ChiranjitPatel/ttsky26d_analog_ADC/docs/specs/layout_briefs/ota.md

# Layout brief — chunk 1b: `ota` (bandgap error amplifier)

**Status: draft 2026-11-08 (night), sizes from the bandgap Phase 2 Monte Carlo.** Final once the bandgap
corner sweep is in (`sim/bandgap/corners.md`).
Schematic: `xschem/ota.sch` (generated by `xschem/gen_ota.py`). Netlist: `sim/out/netlist/ota.spice`.
Why these sizes: `sim/bandgap/README.md` ("Phase 2 — mismatch"). The OTA offset is multiplied by about 10 onto VBG,
so the input pair and the loads are large on purpose. **Matching is the main job of this layout.**

## What it does

This is a two-stage Miller OTA with a PMOS-lvt input. Inputs `inp` = `vb` and `inn` = `va` come from the bandgap
core (about 0.6–0.7 V), and the output `out` = `vgp` drives the gates of the bandgap PMOS current sources. It is
biased from `bias_gen` (`pbias`, 1 µA per pfet_lvt 2/2 unit). Power-down is `pd` = 1.

## Devices

| Name | Device | W / L (µm) | Count | D / G / S / B | Notes |
|---|---|---|---|---|---|
| M1 | pfet_01v8_lvt | 32 / 8 | 1 | d1 / inn / tail / VDPWR | **input pair**, matched with M2 |
| M2 | pfet_01v8_lvt | 32 / 8 | 1 | out1 / inp / tail / VDPWR | |
| M5 | pfet_01v8_lvt | 2 / 2 | 2 (mult) | tail / pbias / VDPWR / VDPWR | tail, 2 µA |
| M3 | nfet_01v8 | 4 / 16 | 1 | d1 / d1 / VGND / VGND | **mirror load**, matched with M4 |
| M4 | nfet_01v8 | 4 / 16 | 1 | out1 / d1 / VGND / VGND | |
| M6 | nfet_01v8 | 4 / 16 | 4 (mult) | out / out1 / VGND / VGND | 2nd stage, 4× the M4 current density |
| M7 | pfet_01v8_lvt | 2 / 2 | 4 (mult) | out / pbias / VDPWR / VDPWR | 2nd-stage load, 4 µA |
| RZ | res_xhigh_po_0p35 | 0.35 / 21 | 1 | out1 – cz | ≈ 120 kΩ; may be split into series units (tell me) |
| CC | cap_mim_m3_1 | 32 × 32 | 1 | cz (bottom, met3) – out (top, met4) | ≈ 2.1 pF |
| MPD | pfet_01v8 | 0.42 / 0.5 | 1 | out / pdb / VDPWR / VDPWR | power-down |
| MND | nfet_01v8 | 0.42 / 0.5 | 1 | out1 / pd / VGND / VGND | power-down |
| MIP, MIN | pfet / nfet_01v8 | 0.84 / 1, 0.42 / 1 | 1 each | pd inverter → pdb | |
| dummies | as below | | | all terminals on the rail | added to the schematic before you draw |

## Matching (CLAUDE.md rule 6)

1. **Input pair M1/M2:** split each into **2 × 16/8** (LVS merges parallel devices) and interdigitate as
   **`D  A B B A  D`** (common centroid, A = M1, B = M2). Dummies are pfet_01v8_lvt 16/8 on VDPWR. Use one
   n-well and the same orientation, with an n-tap guard ring around the pair. Keep `tail` short and
   symmetric to both halves.
2. **Loads M3/M4 + M6:** one row of 4/16 units: **`D  M6 M6 M3 M4 M6 M6  D`**. M3 and M4 sit in the middle,
   next to each other, and the M6 units are symmetric around them. Dummies are nfet 4/16 on VGND. Put a p-tap
   guard ring around the row.
3. **Tail M5 and load M7** are 2/2 units from `pbias`, like the bias_gen unit devices. Their matching isn't
   critical.
4. **CC over the devices:** the 32 × 32 µm MIM (met3 bottom plate `cz`, met4 top plate `out`) can sit over the
   input pair or the load row. Then no met3 routing is allowed there. Put `out` (top plate, met4) on the
   low-impedance side. That's already the schematic's orientation (c1 = out).
5. Keep `inp`/`inn` (to the bandgap's `vb`/`va`) symmetric, short, and away from `out`/`vgp`.

## Outline and pins

This sits inside `bandgap_core` (54 × 94 µm in the floorplan), next to `pnp_array` and `bg_res`
(`layout_briefs/scripted_cells.md`). A target outline of about 40 × 40 µm with CC on top works. Pins:
`inp`, `inn`, `out`, `pbias`, `pd`, VDPWR, VGND on met1/met2, with labels named exactly like that.

## Checks

```bash
python3 layout/check_cell.py ota --gds <your file>.gds
```

```bash
python3 layout/klayout_drc.py <your file>.gds
```

The first runs Magic DRC and LVS against the schematic (dummies included), the second the TT KLayout deck.
