ChiranjitPatel/ttsky26d_analog_ADC/sim/bandgap/corners.md

# bandgap_core — Phase 2 corners (generated by corners_report.py)

63 runs: corners tt/ff/ss/fs/sf/ll/hh (ll/hh = low/high resistor corner) × −40/27/125 °C × VDPWR 1.62/1.80/1.98 V. Failed runs: 0.

## VBG at 27 °C, 1.80 V

| corner | VBG (V) | vs tt | TC −40…125 °C (ppm/°C) | line (mV/V) |
|---|---|---|---|---|
| tt | 1.2105 | +0.00 % | 23.5 | 2.22 |
| ff | 1.2059 | -0.38 % | 33.3 | 1.98 |
| ss | 1.2146 | +0.34 % | 20.3 | 2.72 |
| fs | 1.2103 | -0.02 % | 26.8 | 2.03 |
| sf | 1.2107 | +0.02 % | 22.4 | 2.89 |
| ll | 1.2117 | +0.10 % | 20.7 | 2.32 |
| hh | 1.2093 | -0.10 % | 26.3 | 2.13 |

## Summary over all runs

| Spec | Quantity | Result | Target | |
|---|---|---|---|---|
| B6 | VBG spread, all corners at 27 °C / 1.8 V | 1.2059 … 1.2146 V (-0.4 / +0.3 %) | ±3 % (untrimmed) | ✅ |
| — | VBG, every corner × T × VDD | 1.1983 … 1.2151 V | — | |
| B5 | TC, worst corner (1.8 V) | 33.3 ppm/°C | ≤ 50 ppm/°C | ✅ |
| B4 | Line regulation, worst run | 9.88 mV/V | ≤ 10 mV/V | ✅ |
| B3 | Startup (1 µs and 100 µs ramps, settles, no oscillation) | 63/63 runs | all | ✅ |

Mismatch (Monte Carlo, `tb_bandgap_mc.spice`, 100 seeds, tt): see `README.md`.
