ChiranjitPatel/ttsky26d_analog_ADC/material/schematics/stage1_bias_gen.png

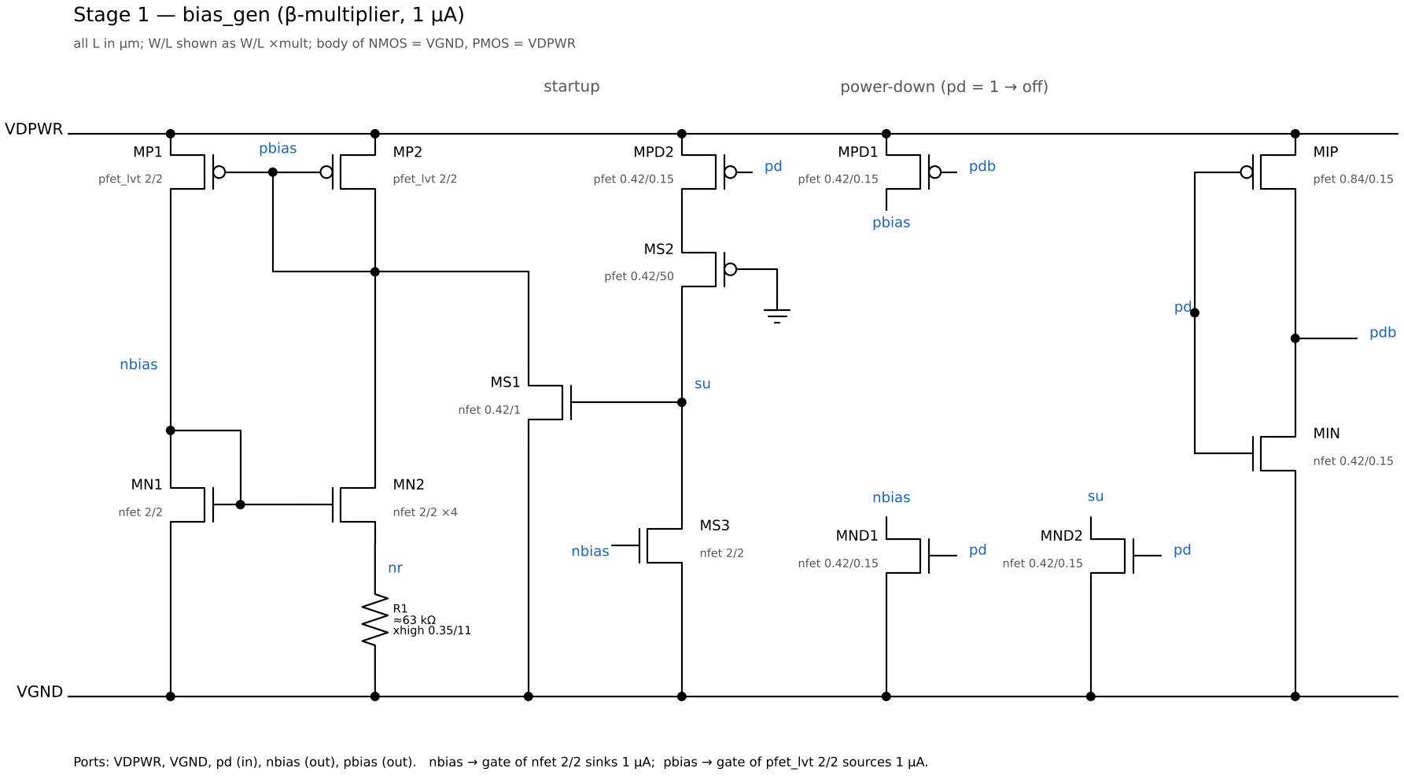
material/schematics/stage1_bias_gen.png
