ChiranjitPatel/ttsky26d_analog_ADC/material/schematics/stage2_ota.png

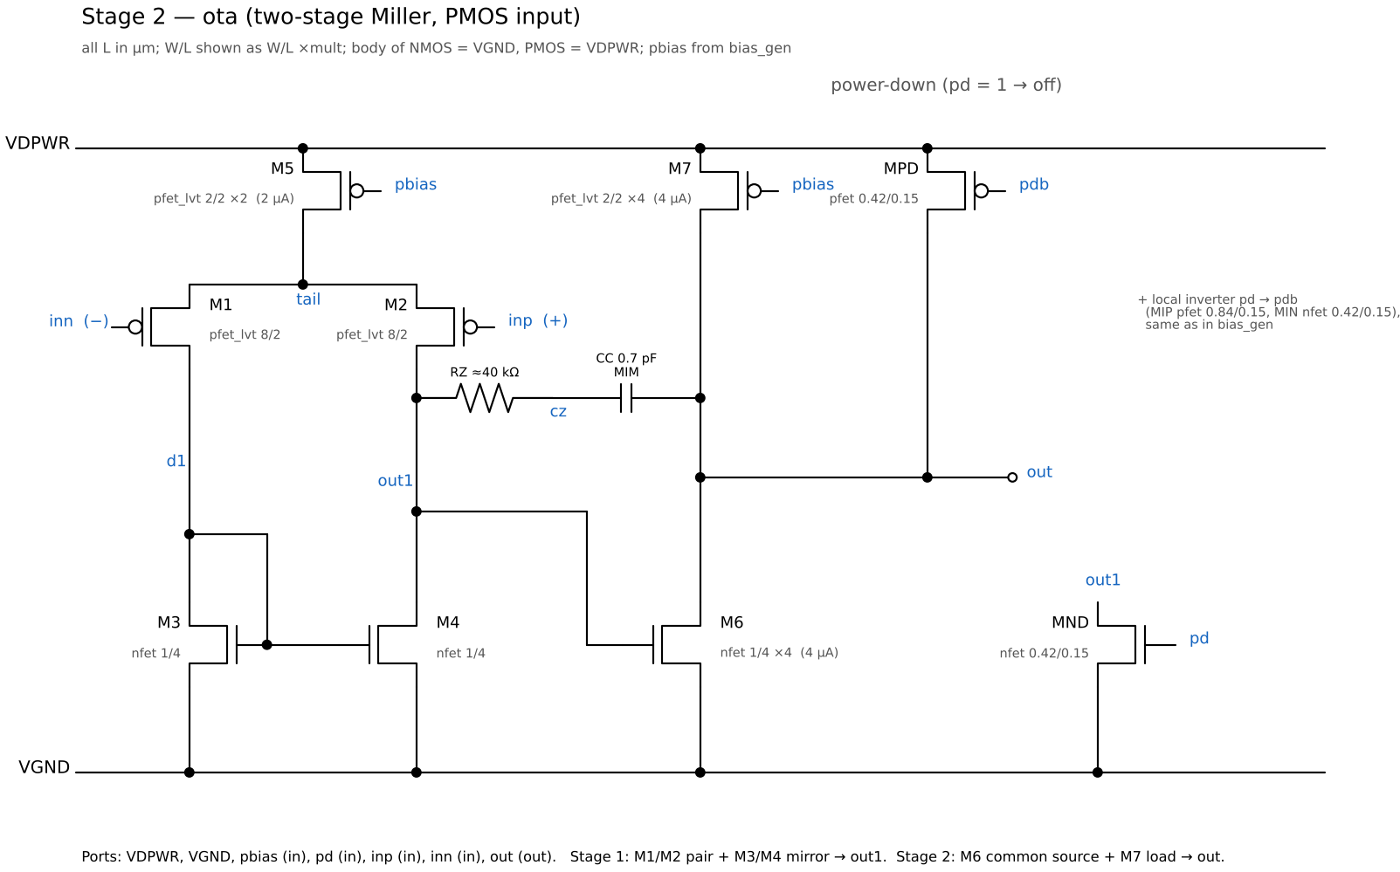
material/schematics/stage2_ota.png
