ChiranjitPatel/ttsky26d_analog_ADC/material/schematics/stage3_bandgap_core.png

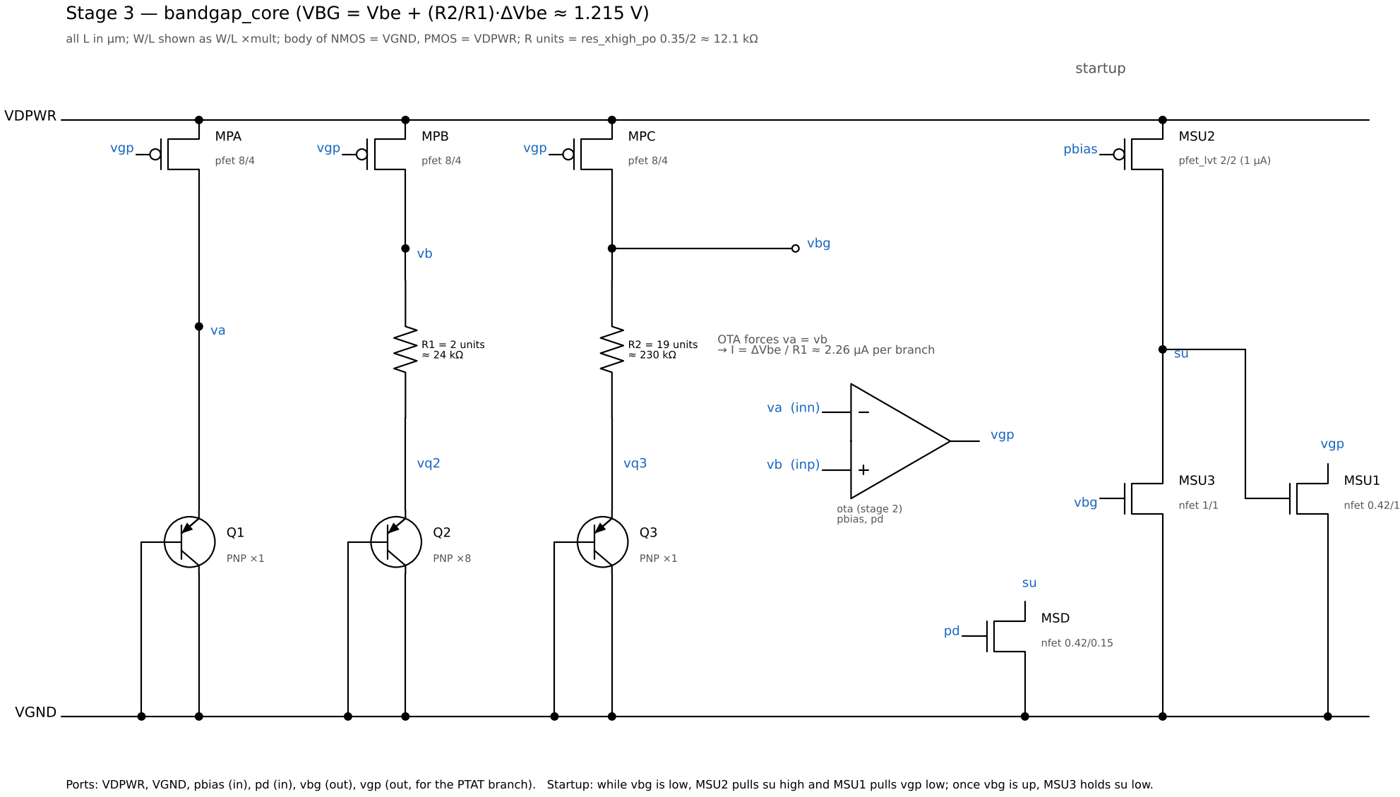
material/schematics/stage3_bandgap_core.png
