ChiranjitPatel/ttsky26d_analog_ADC/material/schematics/stage4_ptat_out.png

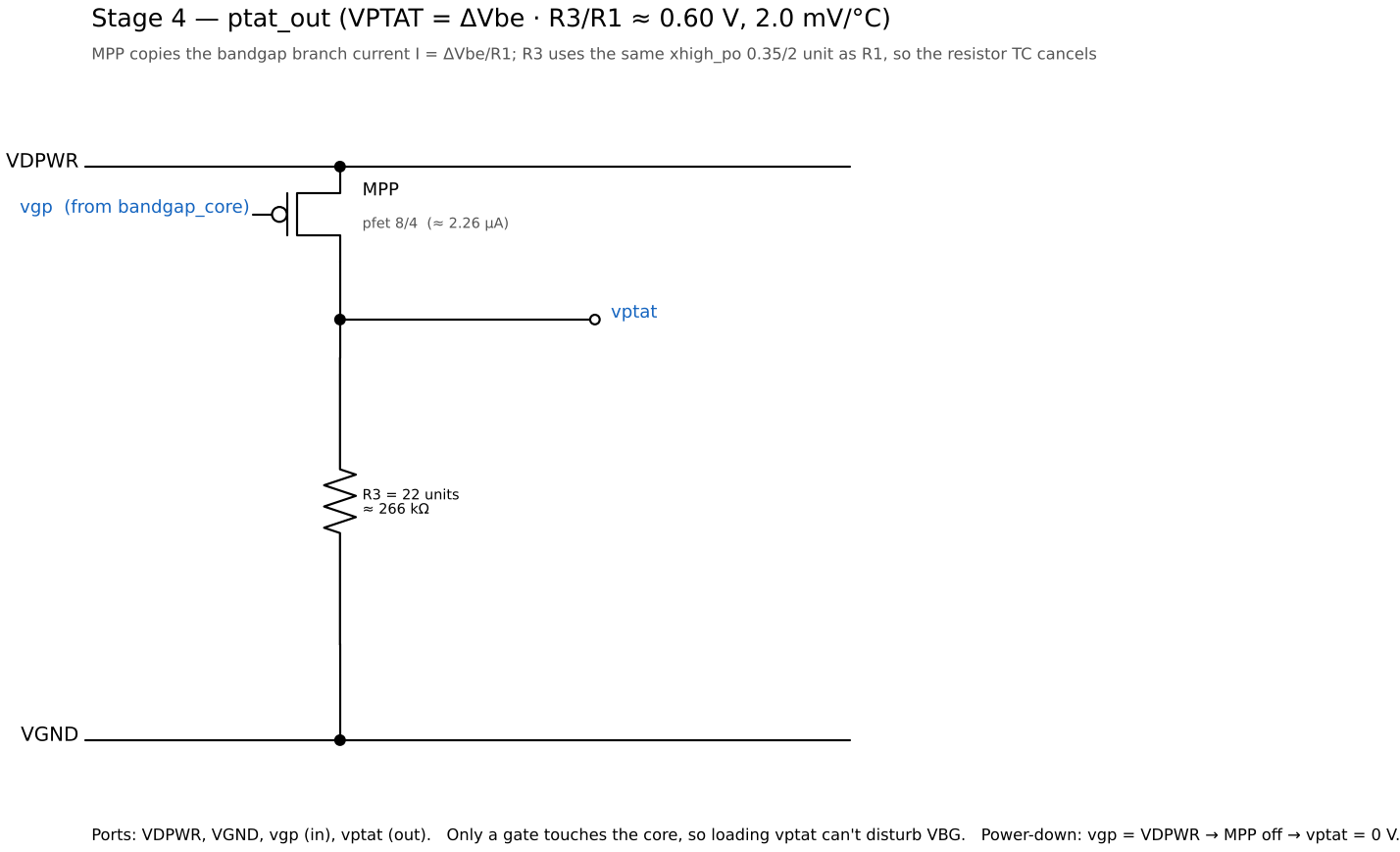
material/schematics/stage4_ptat_out.png
