ChiranjitPatel/ttsky26d_analog_ADC/material/schematics/stage5_vref.png

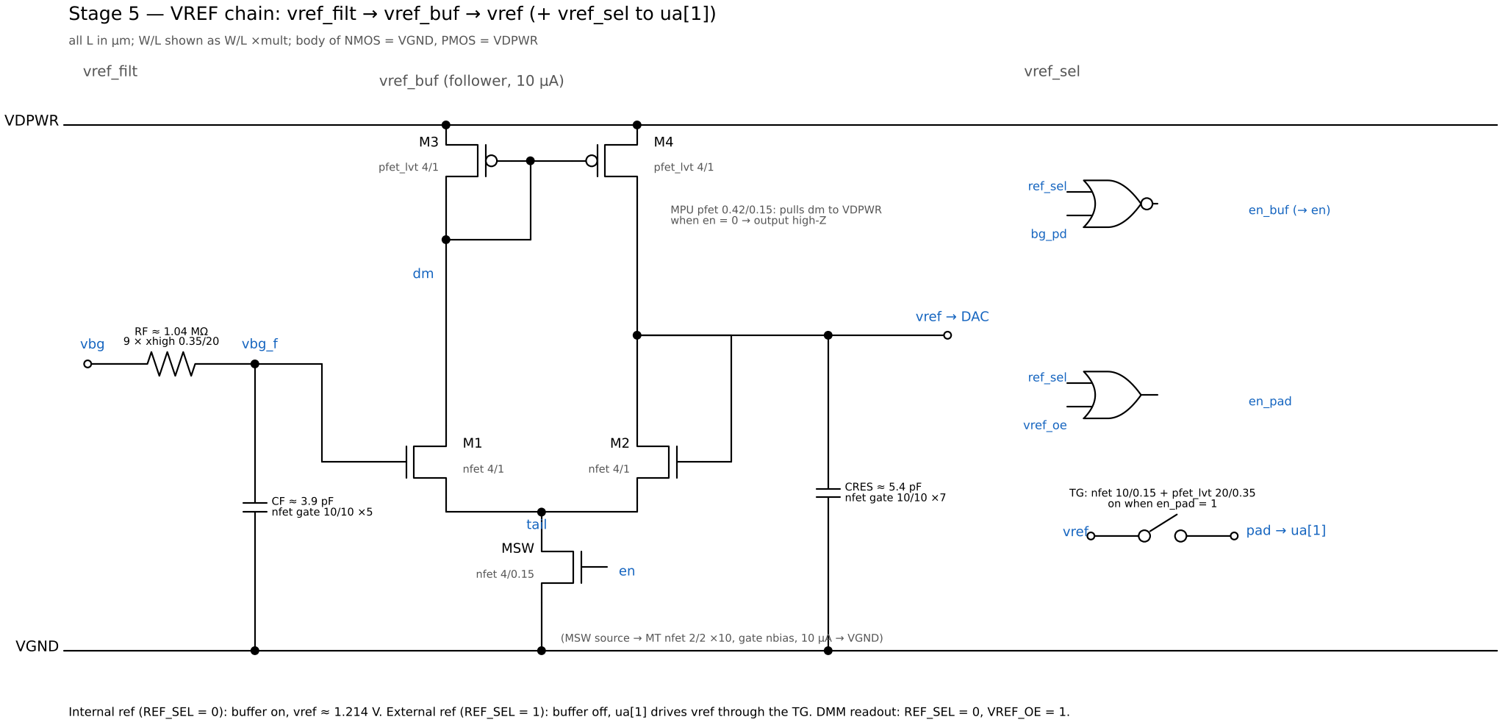
material/schematics/stage5_vref.png
