ChiranjitPatel/ttsky26d_analog_ADC/material/schematics/stage6_comparator.png

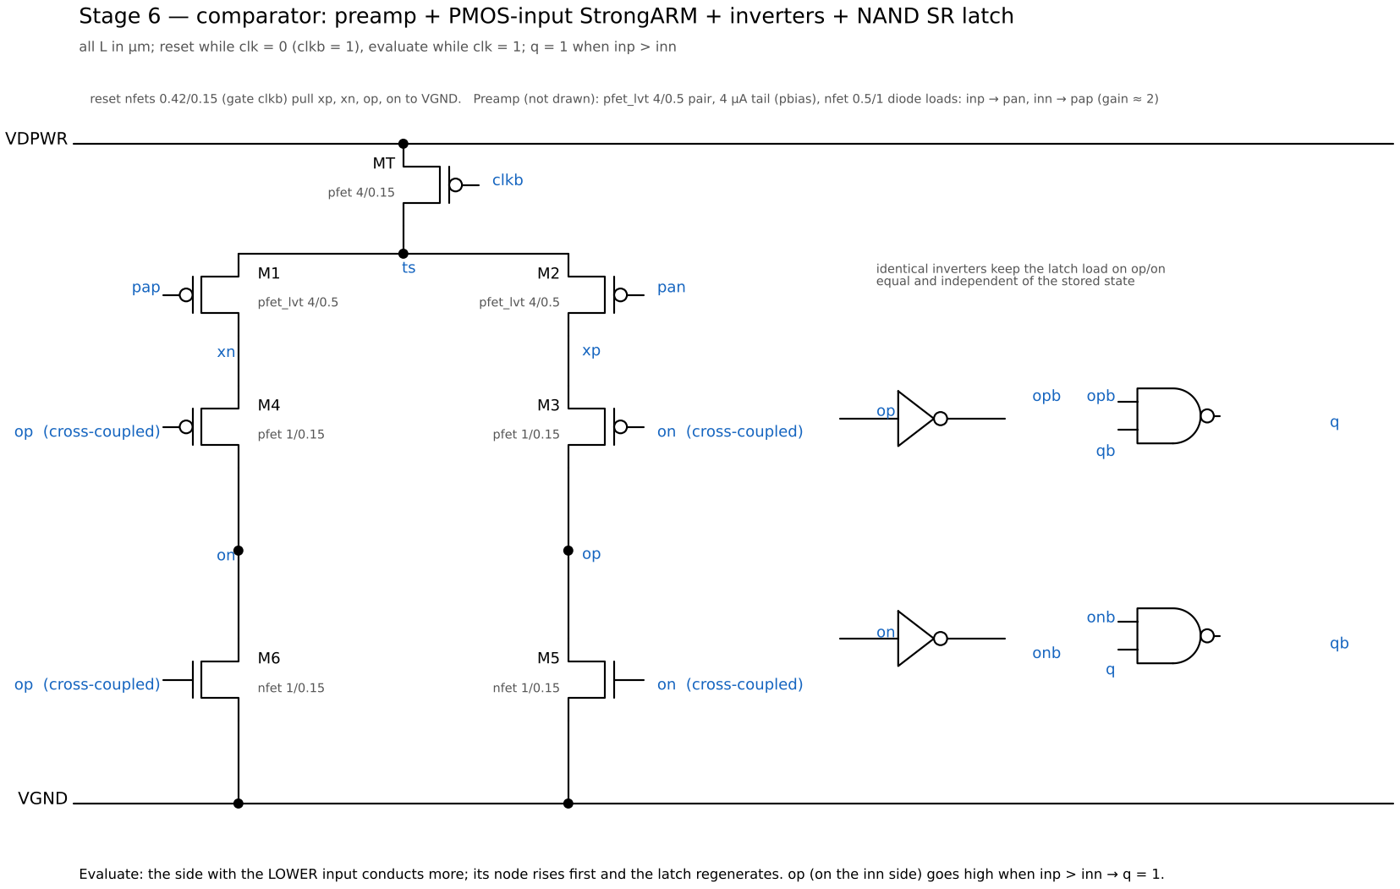
material/schematics/stage6_comparator.png
