ChiranjitPatel/ttsky26d_analog_ADC/material/schematics/stage7_inmux_vcm.png

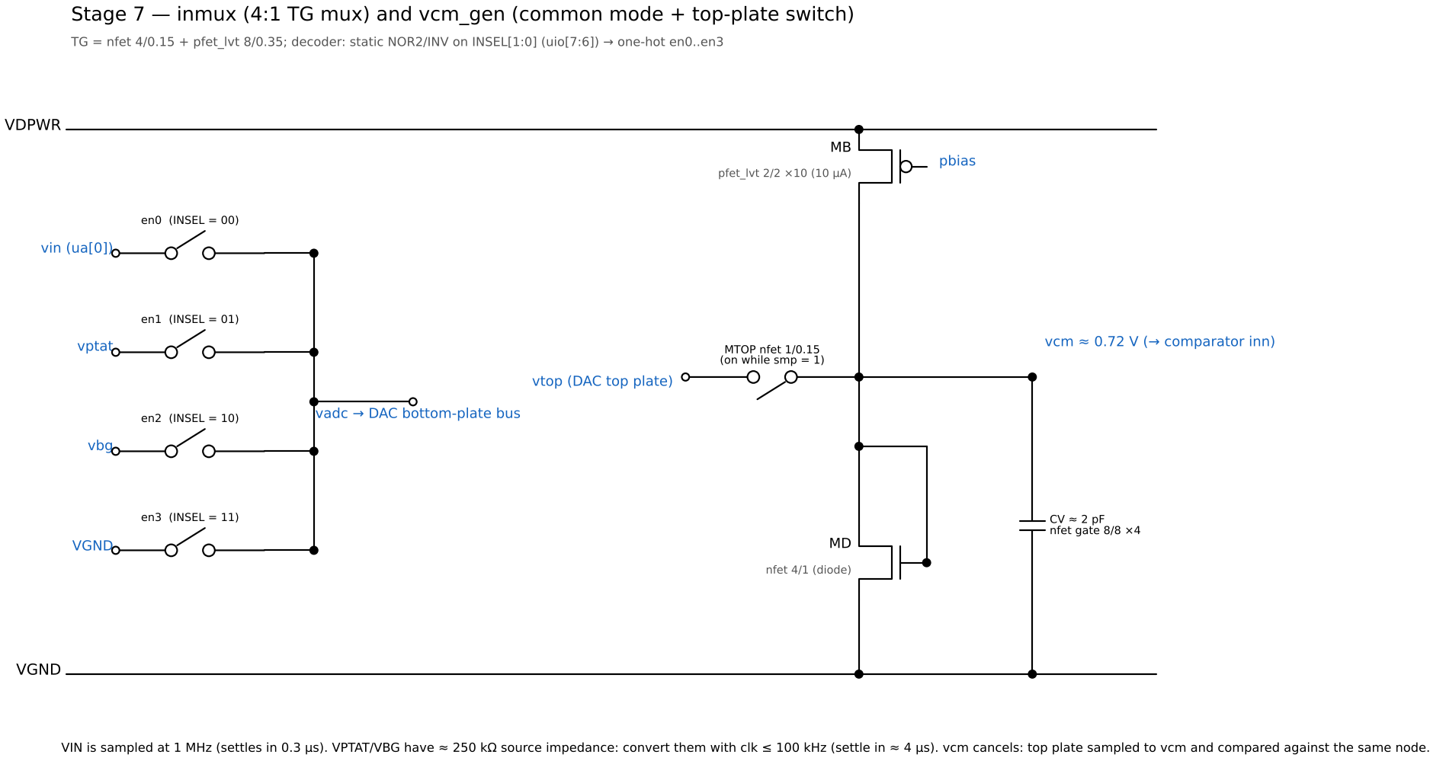
material/schematics/stage7_inmux_vcm.png
