ChiranjitPatel/ttsky26d_analog_ADC/material/schematics/stage8_cap_dac.png

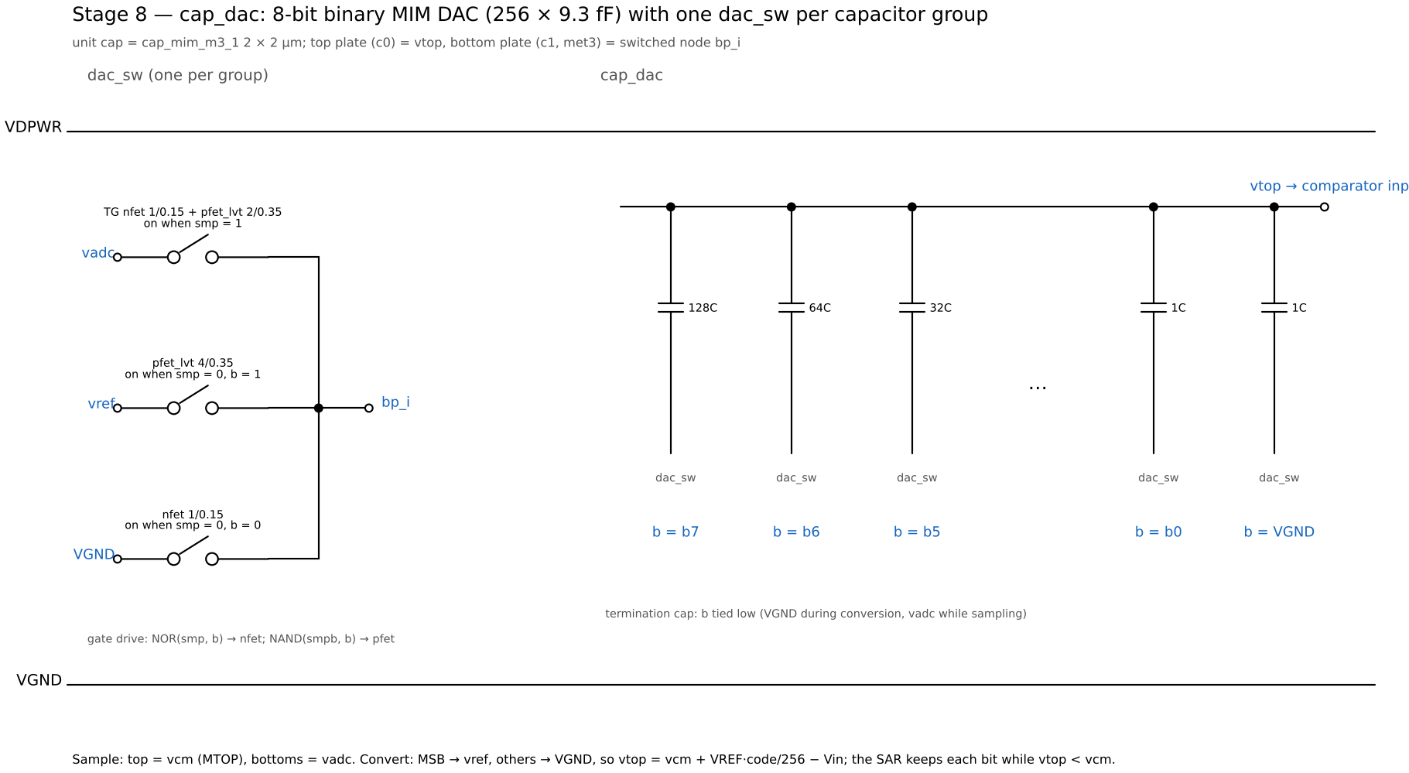
material/schematics/stage8_cap_dac.png
