ChiranjitPatel/ttsky26d_analog_ADC/sim/bandgap/plots/corners.png

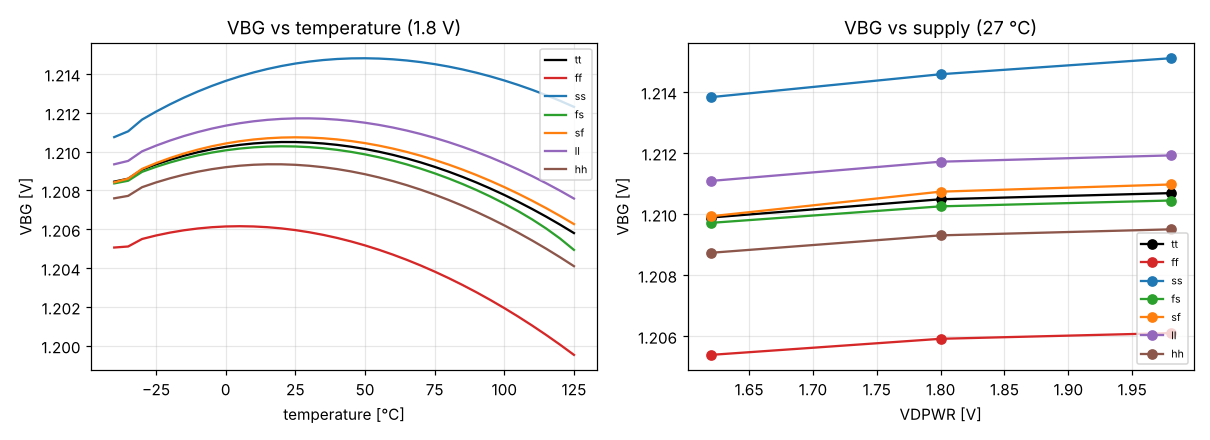
sim/bandgap/plots/corners.png
