ChiranjitPatel/ttsky26d_analog_ADC/sim/bias/plots/corners.png

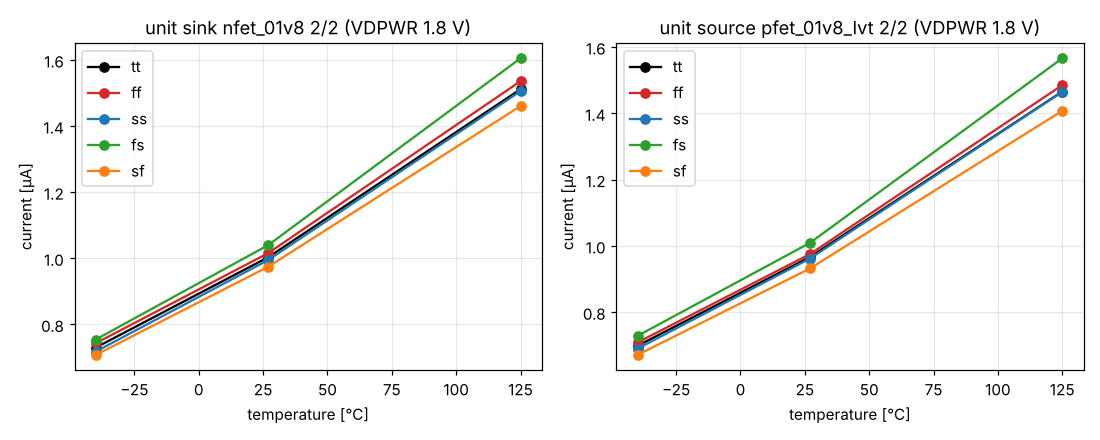
sim/bias/plots/corners.png
