ChiranjitPatel/ttsky26d_analog_ADC/sim/devices/plots/nfet_01v8.png

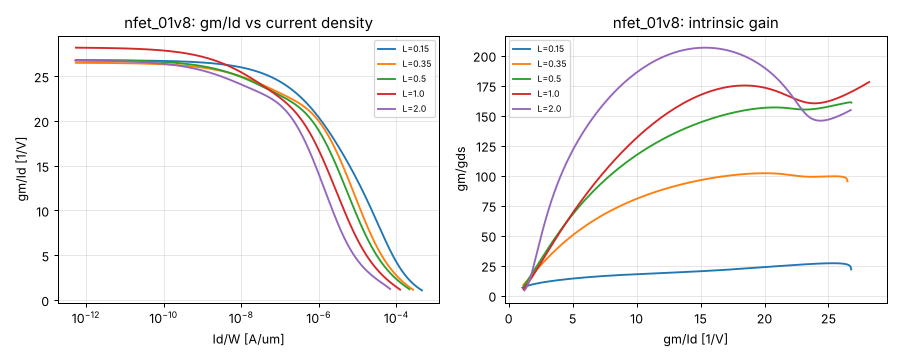
sim/devices/plots/nfet_01v8.png
