ChiranjitPatel/ttsky26d_analog_ADC/sim/devices/plots/pfet_01v8.png

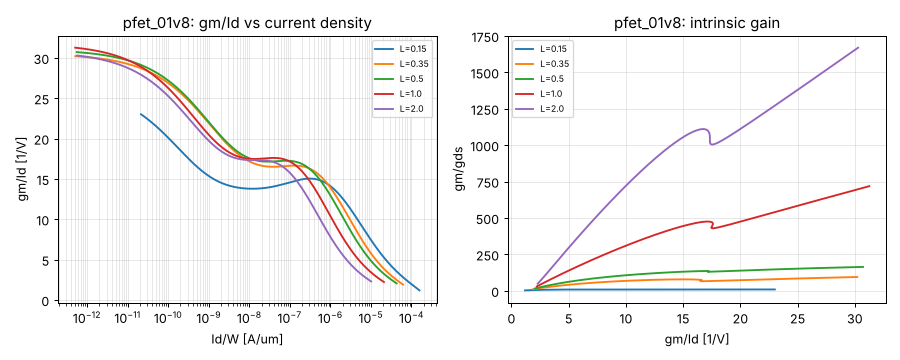
sim/devices/plots/pfet_01v8.png
