ChiranjitPatel/ttsky26d_analog_ADC/sim/devices/plots/pnp.png

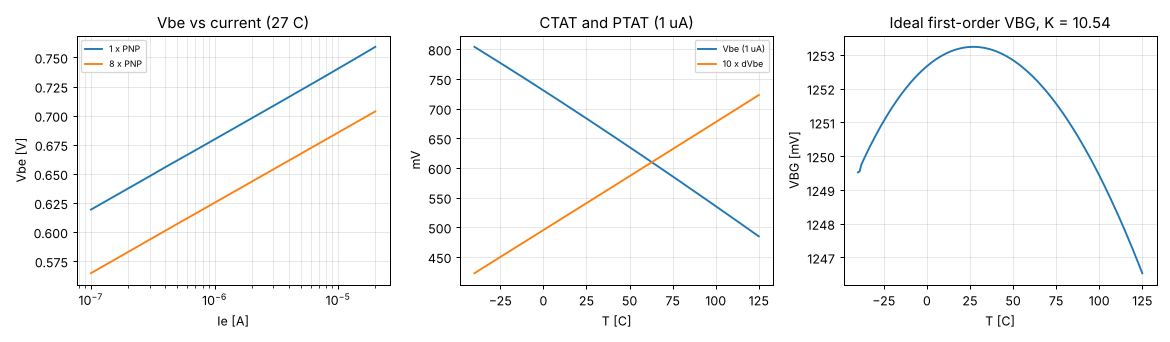
sim/devices/plots/pnp.png
