ChiranjitPatel/ttsky26d_analog_ADC/sim/ptat/plots/sensor.png

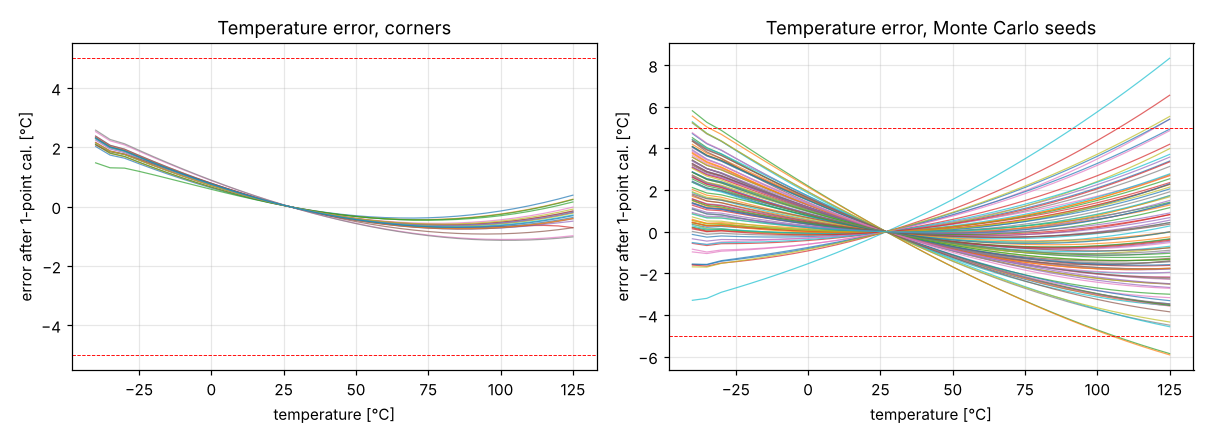
sim/ptat/plots/sensor.png
