ChiranjitPatel/ttsky26d_analog_ADC/material/layout/bandgap_core.png

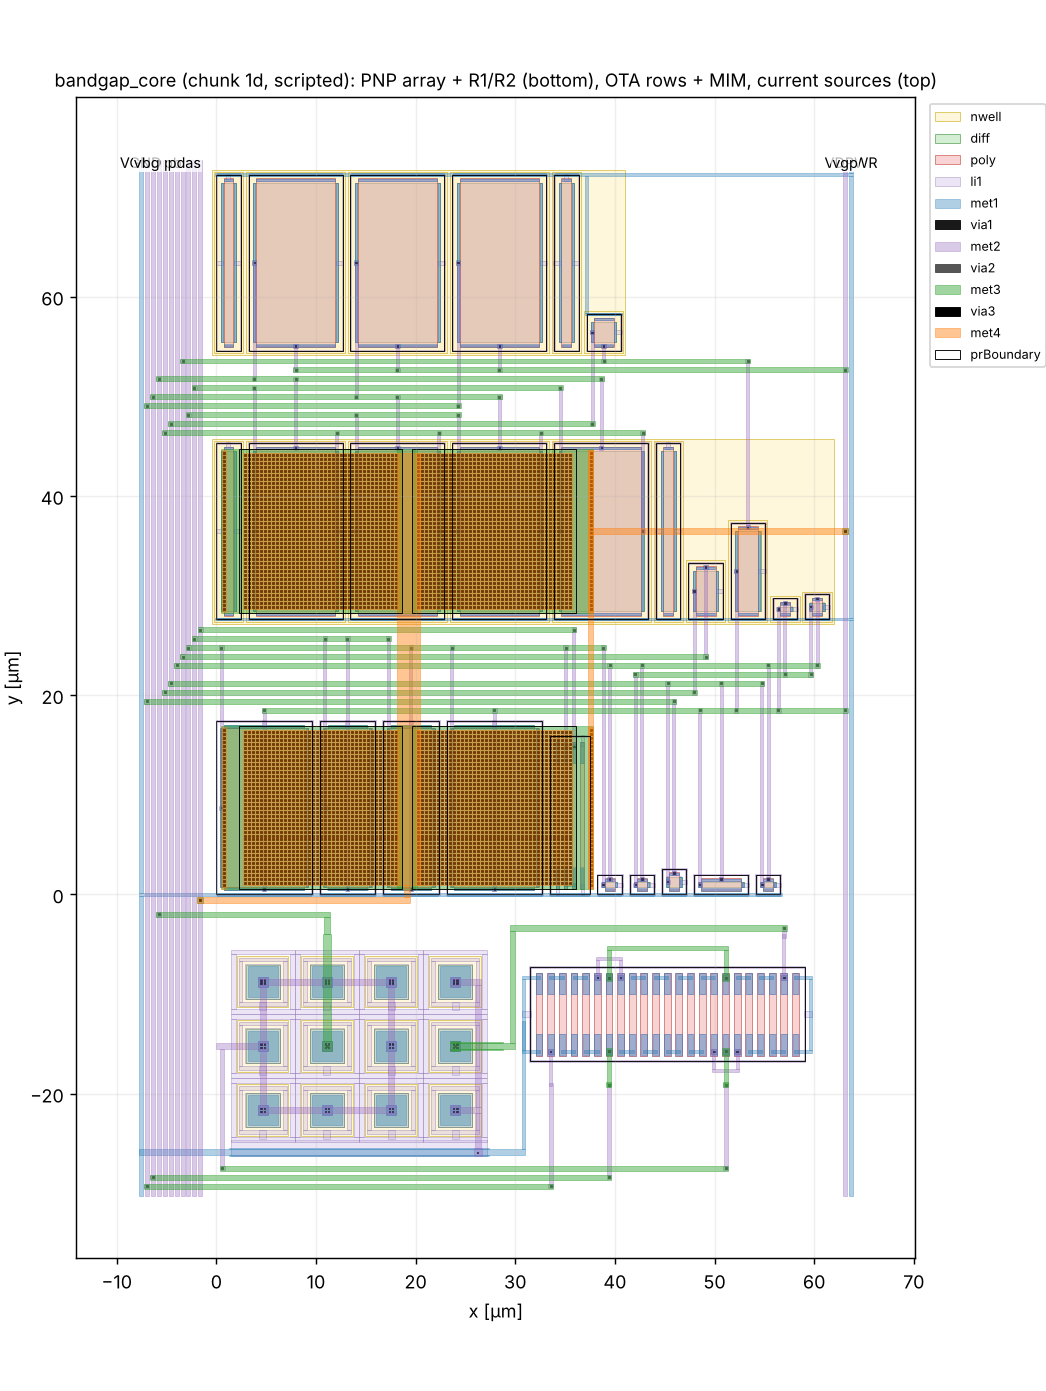
material/layout/bandgap_core.png
