ChiranjitPatel/ttsky26d_analog_ADC/material/layout/bg_res.png

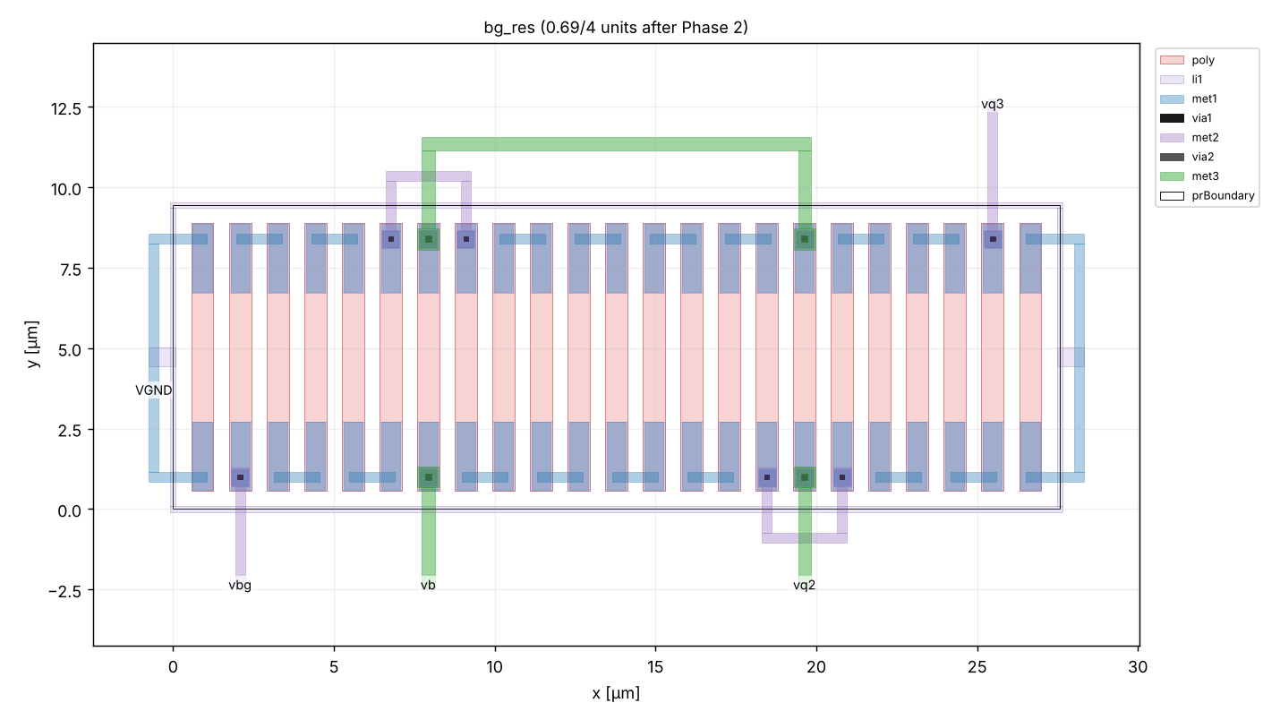
material/layout/bg_res.png
