ChiranjitPatel/ttsky26d_analog_ADC/material/layout/bias_gen.png

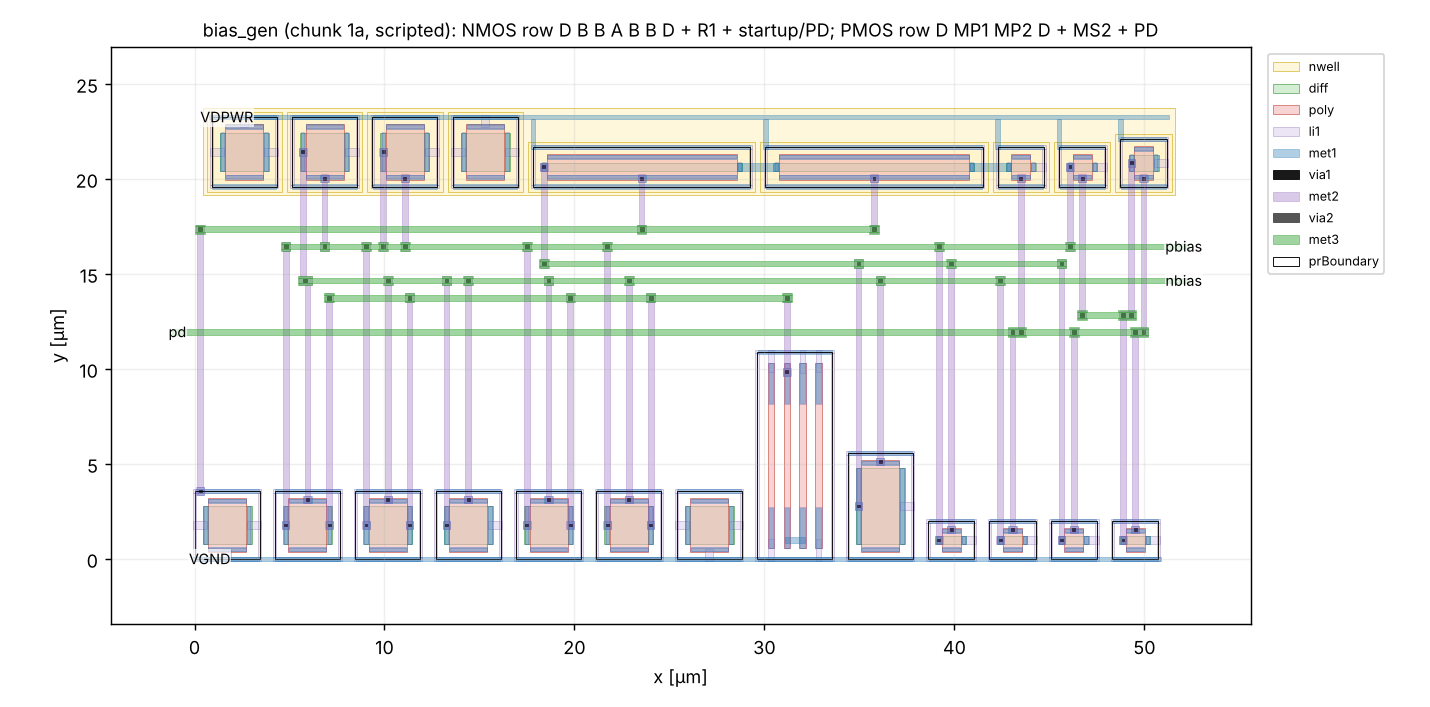
material/layout/bias_gen.png
