ChiranjitPatel/ttsky26d_analog_ADC/material/layout/floorplan.png

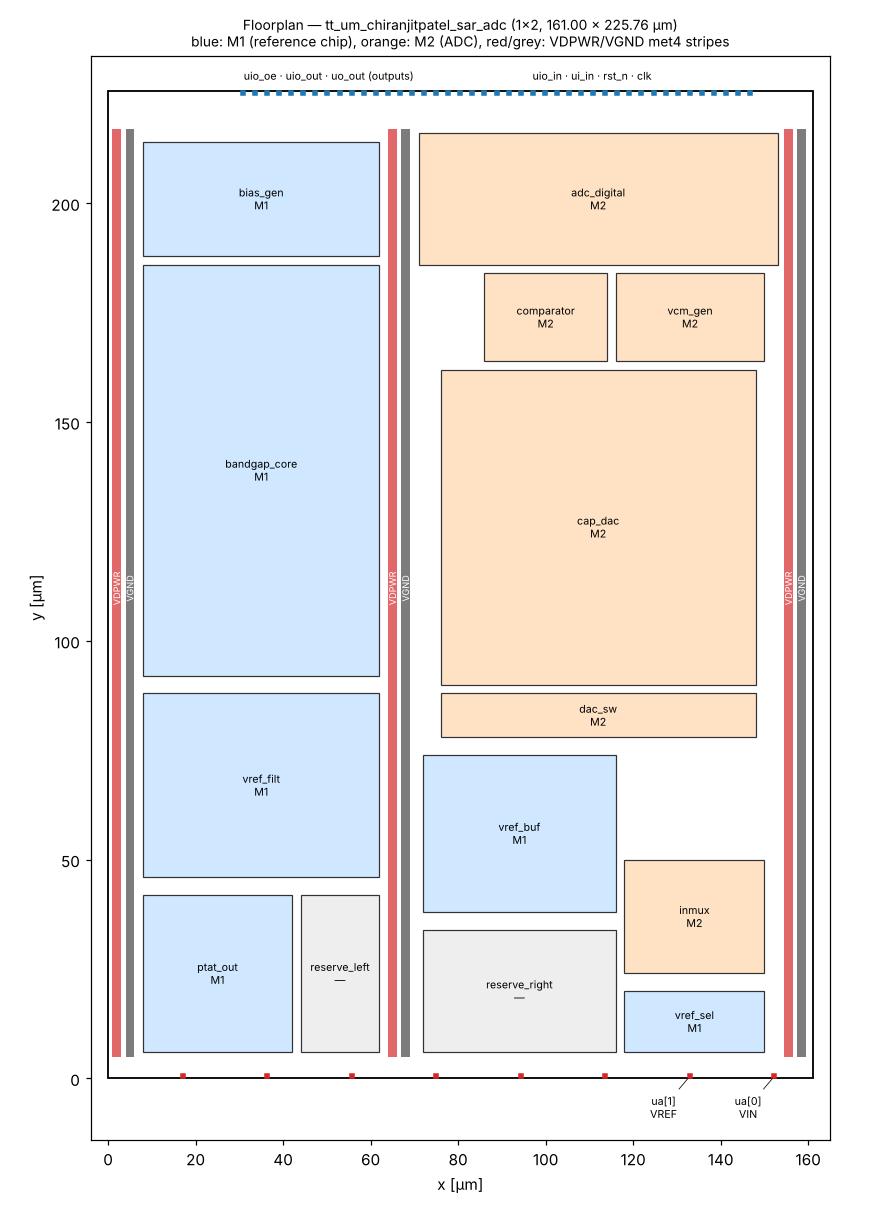
material/layout/floorplan.png
