ChiranjitPatel/ttsky26d_analog_ADC/material/layout/m0_frame.png

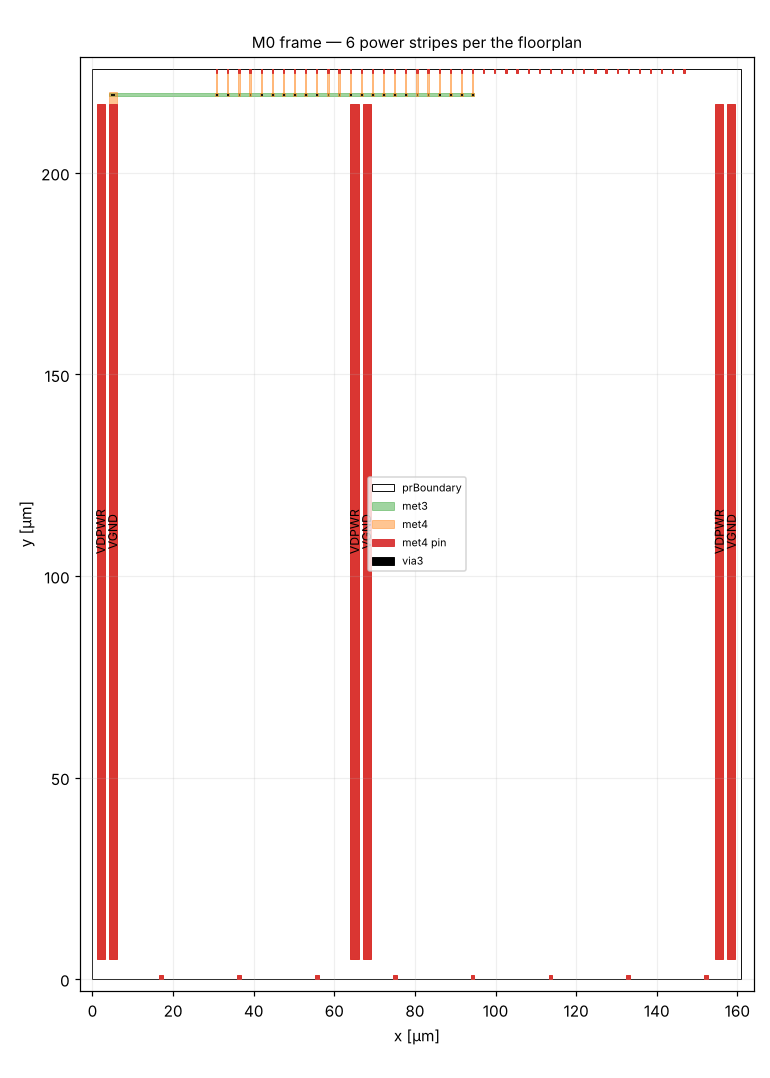
material/layout/m0_frame.png
