ChiranjitPatel/ttsky26d_analog_ADC/material/layout/ota.png

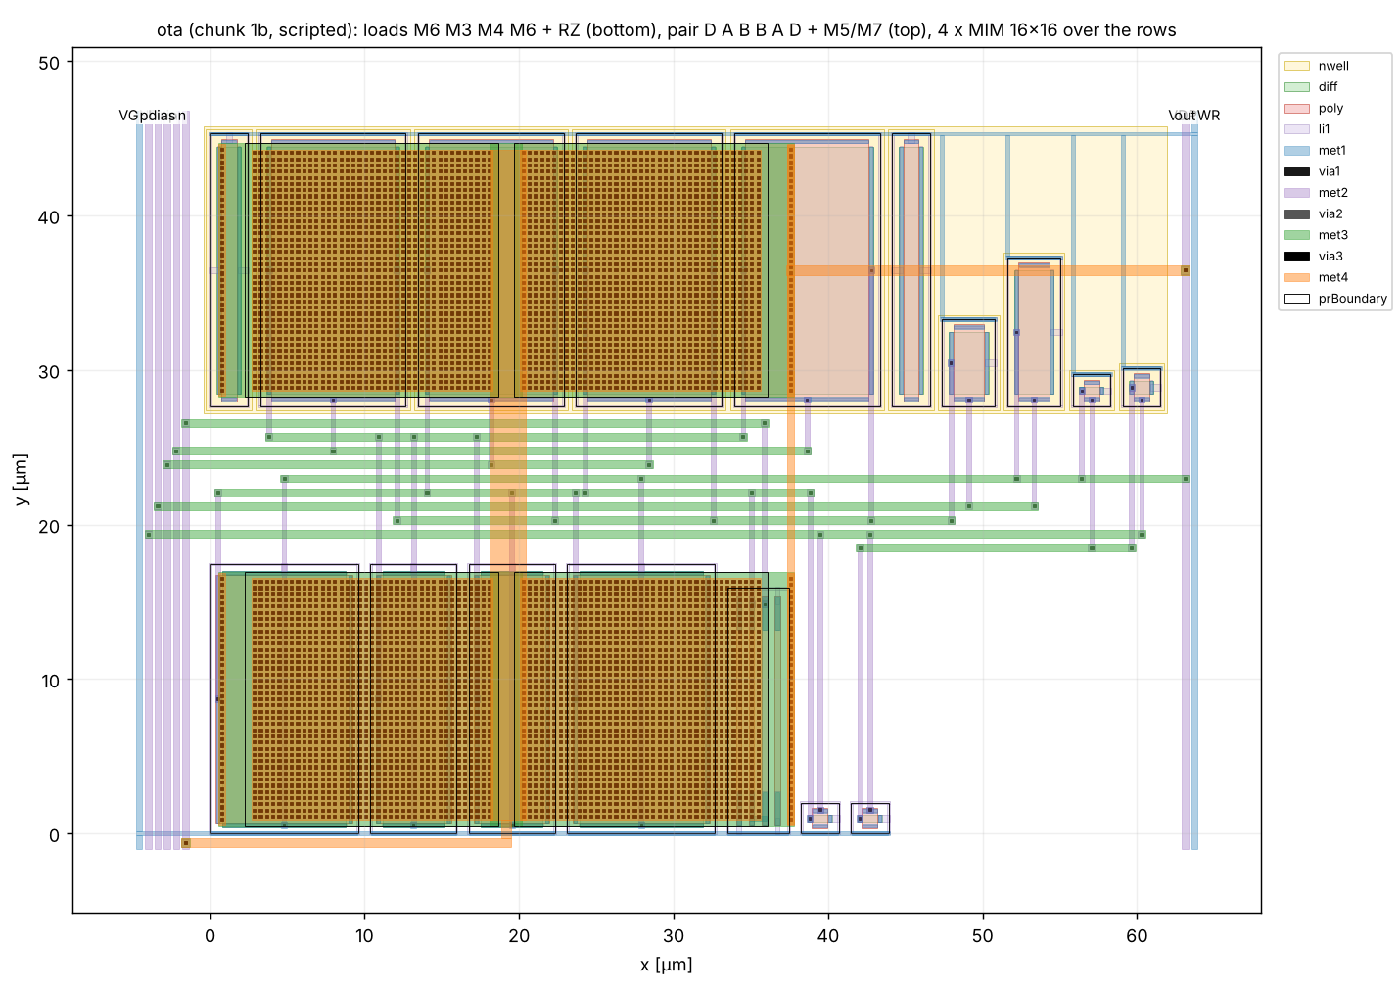
material/layout/ota.png
