ChiranjitPatel/ttsky26d_analog_ADC/material/layout/pnp_array.png

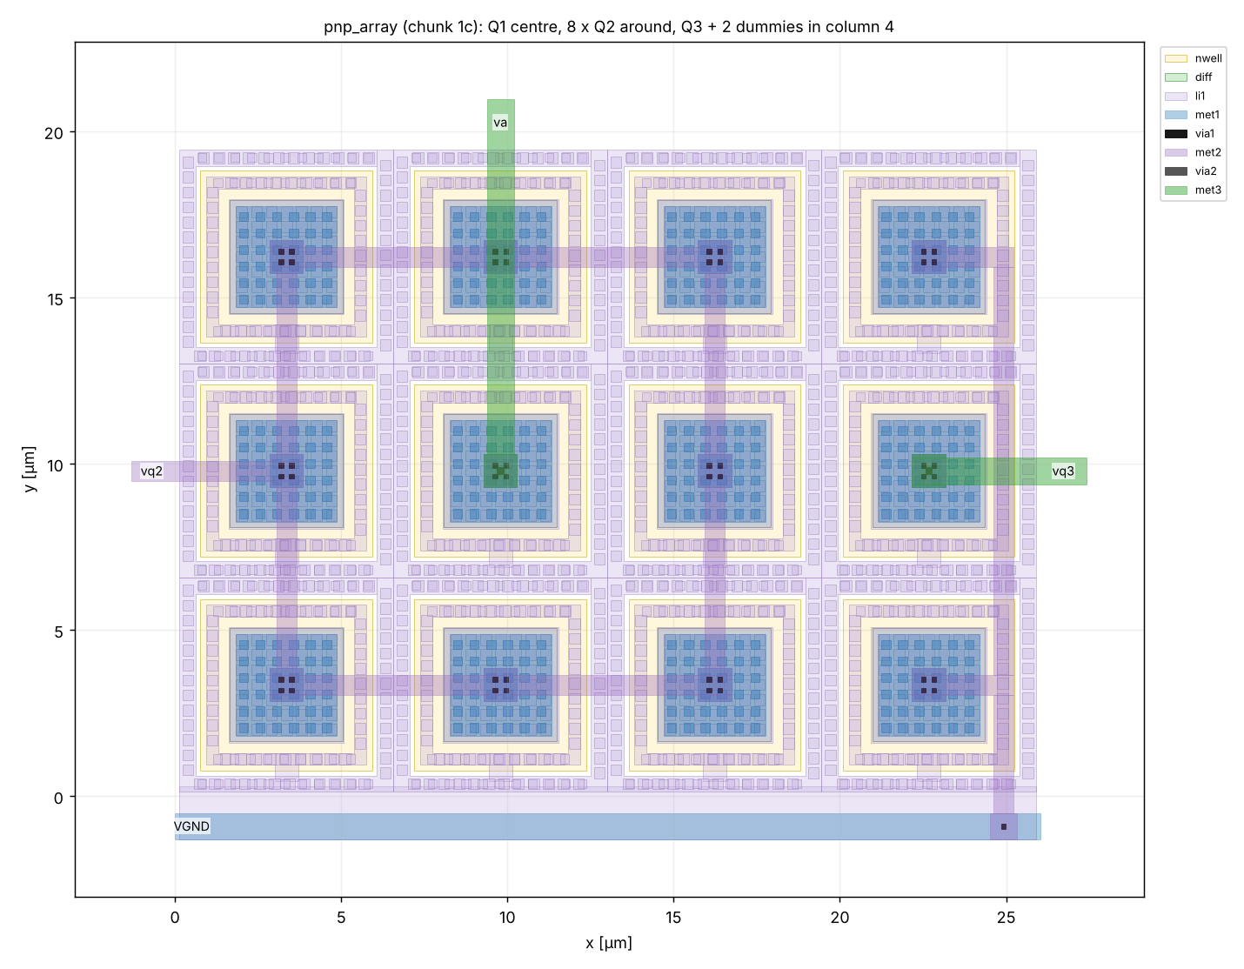
material/layout/pnp_array.png
