ChiranjitPatel/ttsky26d_analog_ADC/material/layout/ptat_out.png

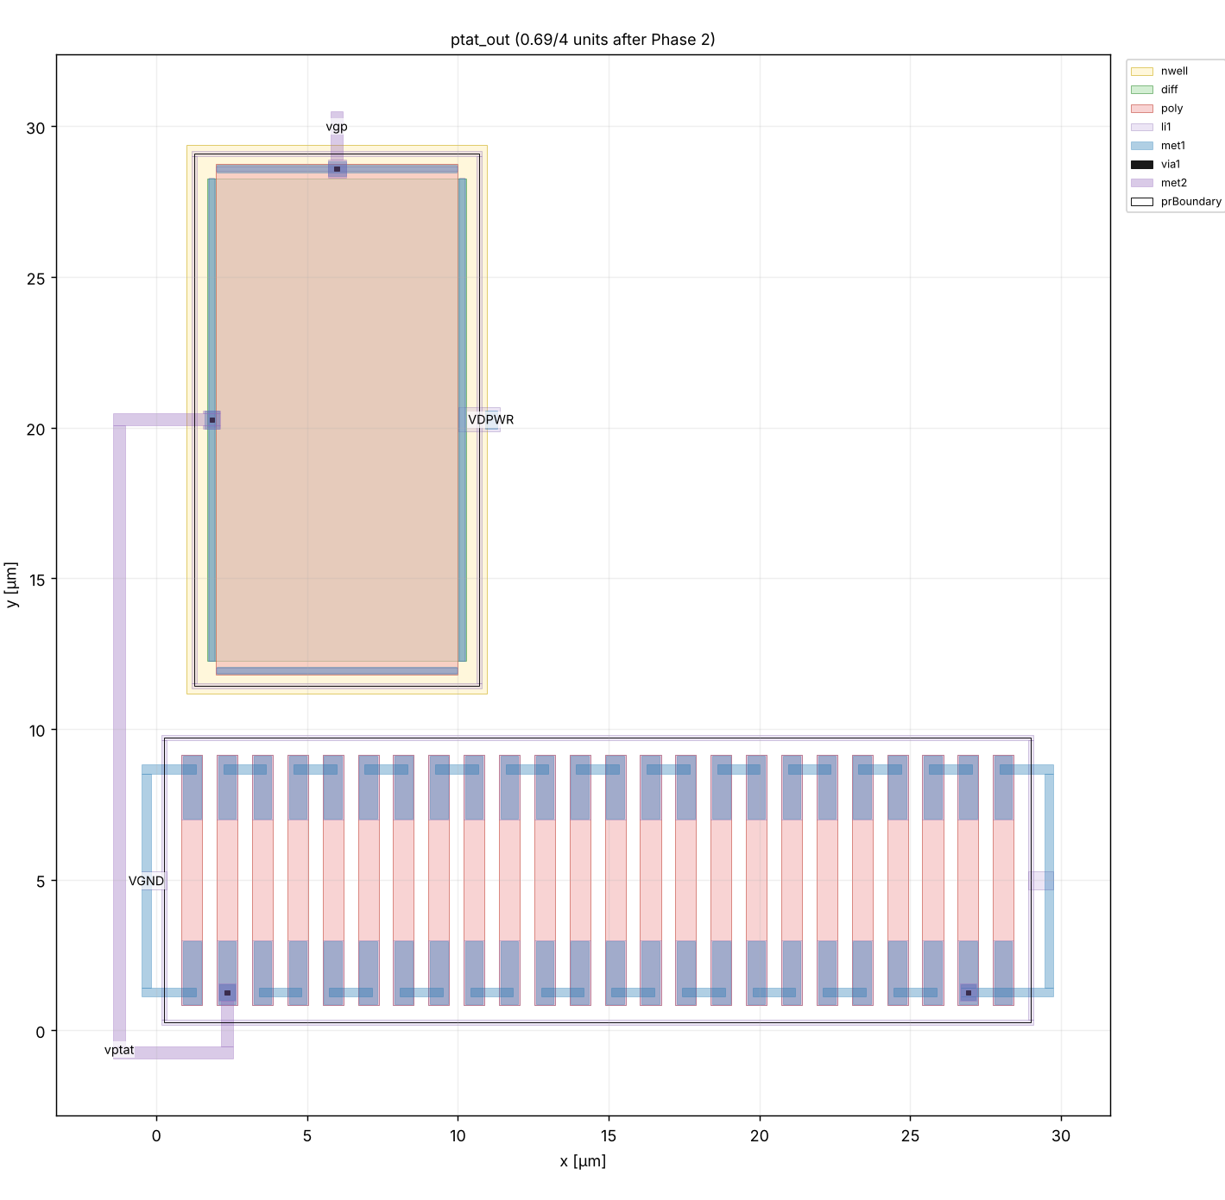
material/layout/ptat_out.png
