ChiranjitPatel/ttsky26d_analog_ADC/material/layout/vref_buf.png

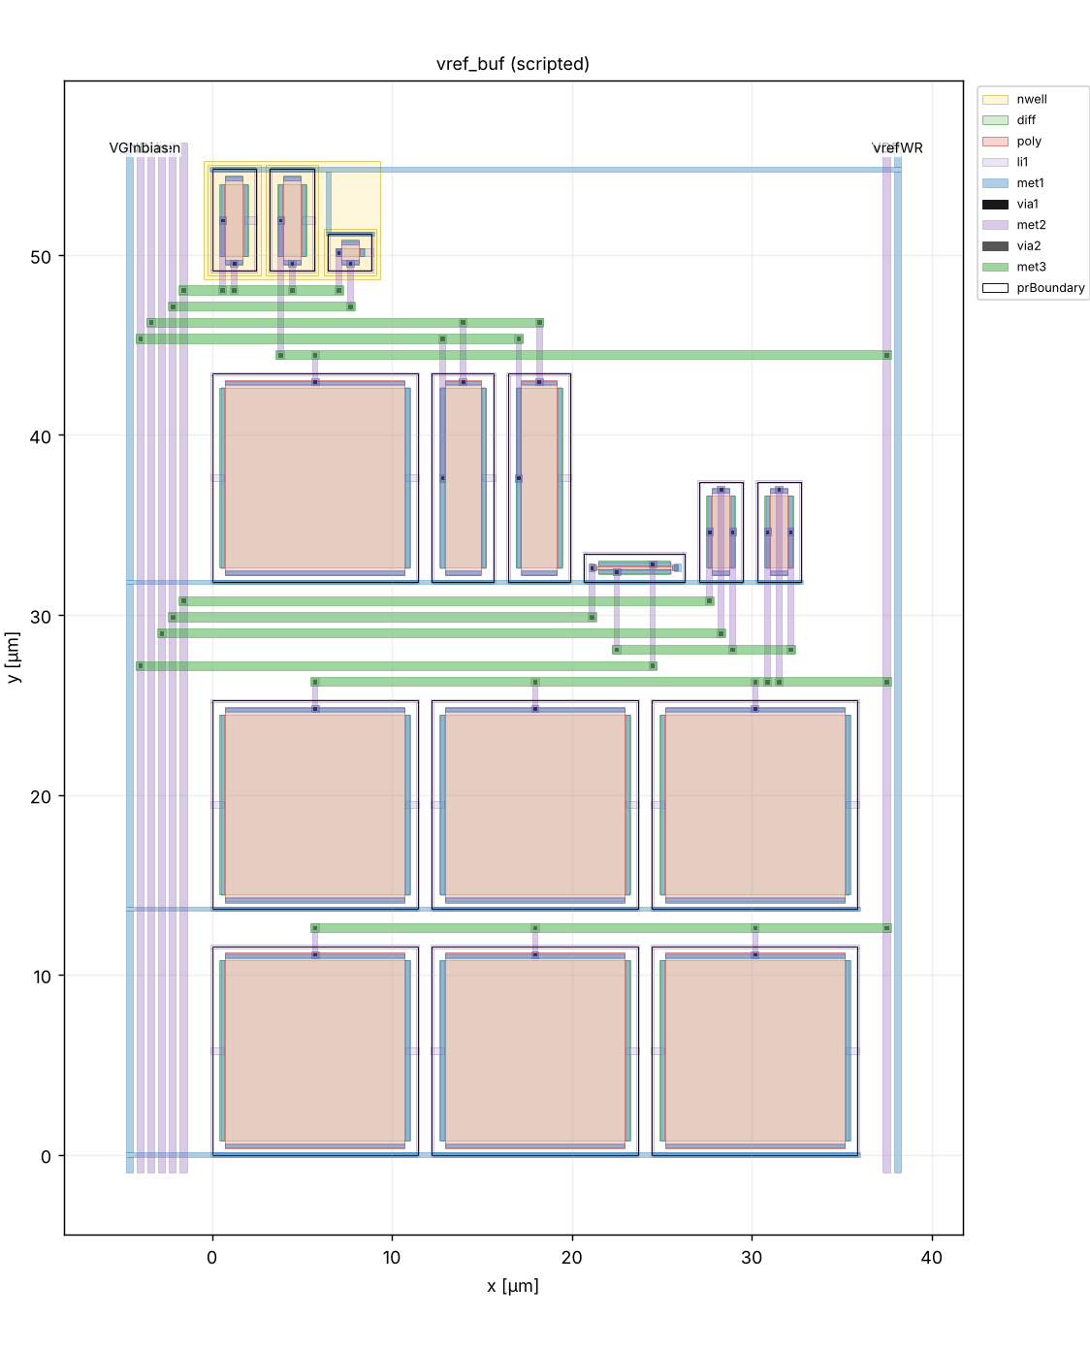
material/layout/vref_buf.png
