ChiranjitPatel/ttsky26d_analog_ADC/material/layout/vref_filt.png

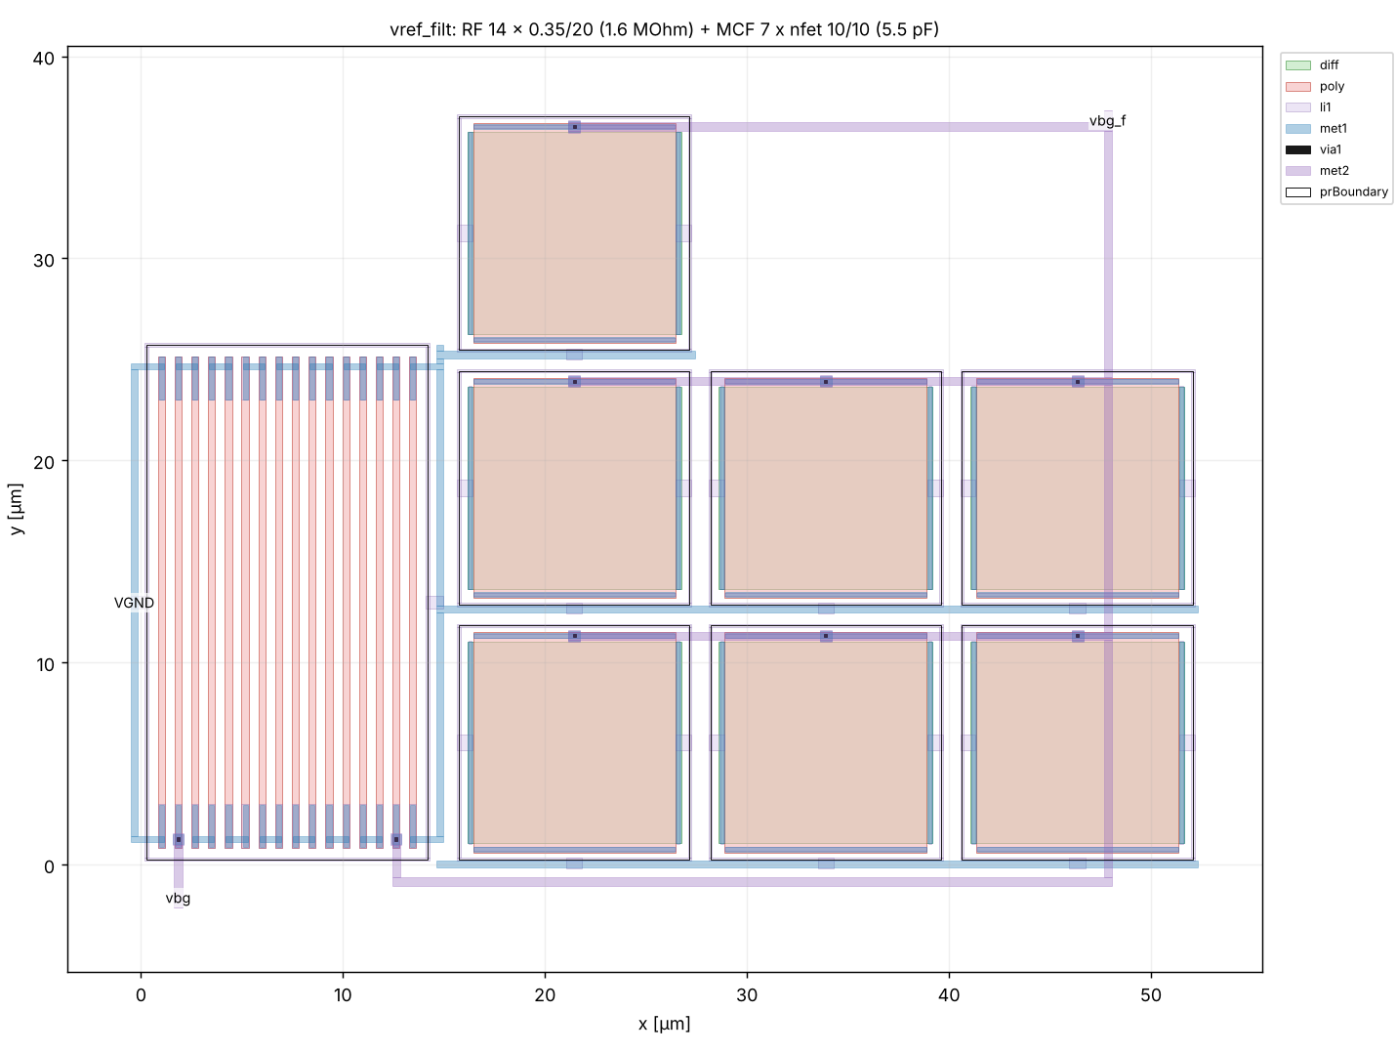
material/layout/vref_filt.png
