ChiranjitPatel/ttsky26d_analog_ADC/material/layout/vref_sel.png

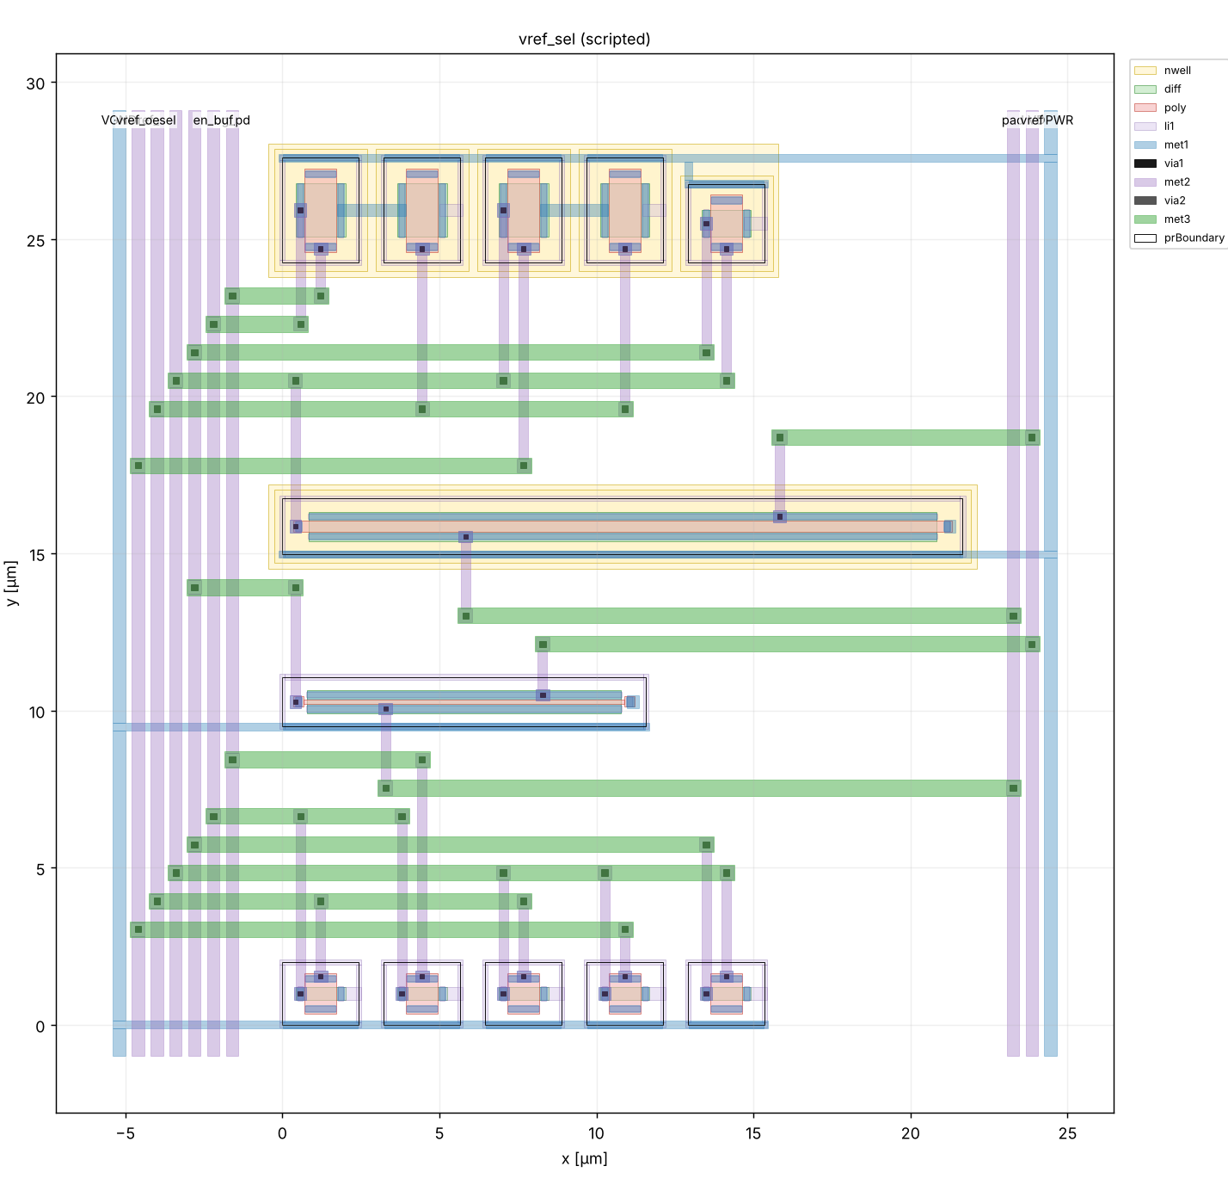
material/layout/vref_sel.png
