ChiranjitPatel/ttsky26d_analog_ADC/sim/devices/results.md

# Stage 0 — device sanity results

tt corner, 27 °C, generated by `stage0.py` from `tb_mos/pnp/res/mim.spice`.

## MOSFETs (W = 2 µm, |Vds| = 0.9 V)

| Device | L (µm) | Vth @ \|Vgs\|=0.9 V (V) | Id/W @ gm/Id=10 (µA/µm) | gm/gds @ gm/Id=10 | Id/W @ gm/Id=15 (µA/µm) | gm/gds @ gm/Id=15 |
|---|---|---|---|---|---|---|
| `nfet_01v8` | 0.15 | 0.755 | 23.06 | 18 | 6.233 | 20 |
| `nfet_01v8` | 0.35 | 0.645 | 12.24 | 80 | 4.316 | 96 |
| `nfet_01v8` | 0.5 | 0.632 | 8.43 | 117 | 2.965 | 144 |
| `nfet_01v8` | 1.0 | 0.603 | 4.44 | 132 | 1.557 | 167 |
| `nfet_01v8` | 2.0 | 0.553 | 2.33 | 185 | 0.818 | 207 |
| `pfet_01v8` | 0.15 | 0.668 | 4.61 | 9 | 0.230 | 9 |
| `pfet_01v8` | 0.35 | 0.934 | 2.96 | 69 | 0.654 | 79 |
| `pfet_01v8` | 0.5 | 0.958 | 2.14 | 107 | 0.545 | 131 |
| `pfet_01v8` | 1.0 | 0.991 | 1.13 | 307 | 0.290 | 443 |
| `pfet_01v8` | 2.0 | 1.012 | 0.55 | 724 | 0.131 | 1059 |
| `nfet_01v8_lvt` | 0.15 | 0.546 | 33.12 | 14 | 13.127 | 14 |
| `nfet_01v8_lvt` | 0.35 | 0.544 | 13.10 | 69 | 4.580 | 79 |
| `nfet_01v8_lvt` | 0.5 | 0.525 | 9.32 | 93 | 3.079 | 105 |
| `nfet_01v8_lvt` | 1.0 | 0.490 | 4.32 | 81 | 1.517 | 83 |
| `nfet_01v8_lvt` | 2.0 | 0.464 | 2.11 | 110 | 0.695 | 112 |
| `pfet_01v8_lvt` | 0.35 | 0.291 | 1.61 | 16 | 0.251 | 18 |
| `pfet_01v8_lvt` | 0.5 | 0.374 | 1.35 | 28 | 0.195 | 26 |
| `pfet_01v8_lvt` | 1.0 | 0.424 | 0.71 | 79 | 0.132 | 69 |
| `pfet_01v8_lvt` | 2.0 | 0.417 | 0.31 | 151 | 0.065 | 134 |

Full tables: `lut/<device>.csv`. Plots: `plots/<device>.png`.

## PNP `pnp_05v5_W3p40L3p40` (diode-connected)

| Quantity | Value |
|---|---|
| Vbe @ 1 µA, 27 °C | 679.6 mV |
| dVbe/dT @ 1 µA (CTAT) | -1.918 mV/K |
| ΔVbe (1 vs 8 devices, same current) @ 27 °C | 54.42 mV (ideal kT/q·ln8 = 53.78 mV) |
| Effective ideality n | 1.0119 |
| dΔVbe/dT (PTAT) | 181.9 µV/K |

### What this means for the bandgap (first-order, ideal amplifier)

- Zero-TC gain on ΔVbe: **K = 10.54** (VBG = Vbe + K·ΔVbe). The resistor ratio that sets K depends on the core topology chosen in stage 3.
- Predicted VBG @ 27 °C: **1253 mV**. Curvature over −40…125 °C: 6.7 mV ≈ **32 ppm/°C** (box method) — inside spec B5 (≤ 50 ppm/°C).
- PTAT output for VPTAT(27 °C) = 0.6 V needs gain 11.02 on ΔVbe → slope **2.01 mV/°C** (spec B11 ≥ 1.8 mV/°C).

## Poly resistors (W = 0.35 µm)

| Device | Sheet R (Ω/□) | End R (Ω) | R(L=20 µm) (kΩ) | TC1 (ppm/K) |
|---|---|---|---|---|
| `res_xhigh_po_0p35` | 2004 | 312 | 115.1 | -1468 |
| `res_high_po_0p35` | 386 | 312 | 22.7 | 492 |

## MIM capacitor `cap_mim_m3_1`

| Quantity | Value |
|---|---|
| C(2 × 2 µm) — DAC unit cap | **9.30 fF** |
| C(5 × 5 µm) | 53.28 fF |
| C(10 × 10 µm) | 206.58 fF |
| Area term Ca | 2.000 fF/µm² |
| Perimeter term Cp | 0.164 fF/µm |
| 2 × 2 µm from fit (check) | 9.31 fF |
| 256-unit DAC total | 2.38 pF |
