ChiranjitPatel/ttsky26d_analog_ADC/sim/adc/tb_sine_0.spice

* I2 — adc_core with ideal VREF: 16 conversions (generated by make_tb.py)
.lib /usr/local/share/pdk/sky130A/libs.tech/ngspice/sky130.lib.spice tt
.include /usr/local/share/pdk/sky130A/libs.ref/sky130_fd_sc_hd/spice/sky130_fd_sc_hd.spice
.include ../out/netlist/bias_gen.spice
.include ../out/netlist/sar_logic.spice
.include ../out/netlist/adc_core.spice
.temp 27
.options reltol=1e-5 abstol=1e-12 vntol=1e-7 chgtol=1e-16
VDD vdd 0 1.8
VPD pd 0 0
xb vdd 0 pd nbias pbias bias_gen
VREF vref 0 1.215
VCLK clk 0 pulse(0 1.8 0.5u 0.5n 0.5n 0.5u 1u)
VRST rst_n 0 pwl(0 0 1.5u 0 1.501u 1.8)
VST start 0 1.8
VMODE mode 0 0
VZ z 0 0
VIN vsrc 0 pwl(1.5e-06 0.6075 1.1499e-05 0.6075 1.15e-05 0.9754481 2.1499e-05 0.9754481 2.15e-05 1.1763555 3.1499e-05 1.1763555 3.15e-05 1.1190143 4.1499e-05 1.1190143 4.15e-05 0.8294564 5.1499e-05 0.8294564 5.15e-05 0.4391349 6.1499e-05 0.4391349 6.15e-05 0.1252476 7.1499e-05 0.1252476 7.15e-05 0.0302929 8.1499e-05 0.0302929 8.15e-05 0.1973781 9.1499e-05 0.1973781 9.15e-05 0.5506501 0.000101499 0.5506501 0.0001015 0.9297307 0.000111499 0.9297307 0.0001115 1.1625254 0.000121499 1.1625254 0.0001215 1.1433501 0.000131499 1.1433501 0.0001315 0.8809101 0.000141499 0.8809101 0.0001415 0.4943476 0.000151499 0.4943476 0.0001515 0.1591539 0.000161499 0.1591539)
RPAD vsrc vadc_pad 500
CPAD vadc_pad 0 5p
x1 vdd 0 pbias vref vadc_pad clk rst_n start mode z z z z z z z z z z d0 d1 d2 d3 d4 d5 d6 d7 eoc cmp adc_core
.control
set wr_singlescale
set wr_vecnames
save v(clk) v(eoc) v(vsrc) v(x1.vtop) v(x1.vcm) v(x1.smpt) v(vref) v(d0) v(d1) v(d2) v(d3) v(d4) v(d5) v(d6) v(d7)
tran 2n 0.000165
wrdata ../out/adc/sine_0.dat v(clk) v(eoc) v(vsrc) v(x1.vtop) v(x1.vcm) v(x1.smpt) v(d0) v(d1) v(d2) v(d3) v(d4) v(d5) v(d6) v(d7) v(vref)
quit
.endc
.end
