ChiranjitPatel/ttsky26d_analog_ADC/sim/adc/tb_edges_b.spice

* I2 — adc_core with ideal VREF: 9 conversions (generated by make_tb.py)
.lib /usr/local/share/pdk/sky130A/libs.tech/ngspice/sky130.lib.spice tt
.include /usr/local/share/pdk/sky130A/libs.ref/sky130_fd_sc_hd/spice/sky130_fd_sc_hd.spice
.include ../out/netlist/bias_gen.spice
.include ../out/netlist/sar_logic.spice
.include ../out/netlist/adc_core.spice
.temp 27
.options reltol=1e-5 abstol=1e-12 vntol=1e-7 chgtol=1e-16
VDD vdd 0 1.8
VPD pd 0 0
xb vdd 0 pd nbias pbias bias_gen
VREF vref 0 1.215
VCLK clk 0 pulse(0 1.8 0.5u 0.5n 0.5n 0.5u 1u)
VRST rst_n 0 pwl(0 0 1.5u 0 1.501u 1.8)
VST start 0 1.8
VMODE mode 0 0
VZ z 0 0
VIN vsrc 0 pwl(1.5e-06 0.6037031 1.1499e-05 0.6037031 1.15e-05 0.6065508 2.1499e-05 0.6065508 2.15e-05 0.6084492 3.1499e-05 0.6084492 3.15e-05 0.9055547 4.1499e-05 0.9055547 4.15e-05 0.9074531 5.1499e-05 0.9074531 5.15e-05 0.9103008 6.1499e-05 0.9103008 6.15e-05 0.9121992 7.1499e-05 0.9121992 7.15e-05 1.2045586 8.1499e-05 1.2045586 8.15e-05 1.206457 9.1499e-05 1.206457)
RPAD vsrc vadc_pad 500
CPAD vadc_pad 0 5p
x1 vdd 0 pbias vref vadc_pad clk rst_n start mode z z z z z z z z z z d0 d1 d2 d3 d4 d5 d6 d7 eoc cmp adc_core
.control
set wr_singlescale
set wr_vecnames
save v(clk) v(eoc) v(vsrc) v(x1.vtop) v(x1.vcm) v(x1.smpt) v(vref) v(d0) v(d1) v(d2) v(d3) v(d4) v(d5) v(d6) v(d7)
tran 2n 9.5e-05
wrdata ../out/adc/edges_b.dat v(clk) v(eoc) v(vsrc) v(x1.vtop) v(x1.vcm) v(x1.smpt) v(d0) v(d1) v(d2) v(d3) v(d4) v(d5) v(d6) v(d7) v(vref)
quit
.endc
.end
