ChiranjitPatel/ttsky26d_analog_ADC/sim/adc/tb_quick_ref.spice

* I2 — adc_core with ideal VREF: 5 conversions (generated by make_tb.py)
.lib /usr/local/share/pdk/sky130A/libs.tech/ngspice/sky130.lib.spice tt
.include /usr/local/share/pdk/sky130A/libs.ref/sky130_fd_sc_hd/spice/sky130_fd_sc_hd.spice
.include ../out/netlist/bias_gen.spice
.include ../out/netlist/sar_logic.spice
.include ../out/netlist/adc_core.spice
.include ../out/netlist/bandgap_core.spice
.include ../out/netlist/vref_filt.spice
.include ../out/netlist/vref_buf.spice
.temp 27
.options reltol=1e-5 abstol=1e-12 vntol=1e-7 chgtol=1e-16
VDD vdd 0 1.8
VPD pd 0 0
xb vdd 0 pd nbias pbias bias_gen
xbg vdd 0 pbias pd vbg vgp bandgap_core
xf 0 vbg vbg_f vref_filt
VEN en 0 1.8
xbuf vdd 0 nbias en vbg_f vref vref_buf
VCLK clk 0 pulse(0 1.8 0.5u 0.5n 0.5n 0.5u 1u)
VRST rst_n 0 pwl(0 0 1.5u 0 1.501u 1.8)
VST start 0 pwl(0 0 3.04e-05 0 3.0401e-05 1.8)
VMODE mode 0 0
VZ z 0 0
VIN vsrc 0 pwl(3.05e-05 0.1 4.0499e-05 0.1 4.05e-05 0.3 5.0499e-05 0.3 5.05e-05 0.6 6.0499e-05 0.6 6.05e-05 0.9 7.0499e-05 0.9 7.05e-05 1.15 8.0499e-05 1.15)
RPAD vsrc vadc_pad 500
CPAD vadc_pad 0 5p
x1 vdd 0 pbias vref vadc_pad clk rst_n start mode z z z z z z z z z z d0 d1 d2 d3 d4 d5 d6 d7 eoc cmp adc_core
.control
set wr_singlescale
set wr_vecnames
save v(clk) v(eoc) v(vsrc) v(x1.vtop) v(x1.vcm) v(x1.smpt) v(vref) v(d0) v(d1) v(d2) v(d3) v(d4) v(d5) v(d6) v(d7)
tran 2n 8.4e-05
wrdata ../out/adc/quick_ref.dat v(clk) v(eoc) v(vsrc) v(x1.vtop) v(x1.vcm) v(x1.smpt) v(d0) v(d1) v(d2) v(d3) v(d4) v(d5) v(d6) v(d7) v(vref)
quit
.endc
.end
