ChiranjitPatel/ttsky26d_analog_ADC/(commit log)

2026-11-01 Add project rules and draft specs for SAR ADC and bandgap
    CLAUDE.md captures the tool flow (xschem, ngspice, KLayout, Magic extraction),
    phased simulation policy and design rules. docs/specs/ holds draft top-level
    pin plan, bandgap spec and 8-bit SAR ADC spec.
    Claude-Session: https://claude.ai/code/session_018xb9mH8bN9u9RTJdbtix1L
2026-11-01 Retarget specs to 1x2 tile with 2 analog pins
    - Pin plan: ua[0] VIN, ua[1] shared AMUX output / external VREF input
    - Add ADC input mux (VIN, VPTAT, VBG, VGND) and PTAT temperature-sensor mode
    - Area budget for 1x2, MIM unit caps, comparator kickback rule
    - Add prior-art survey of earlier TT SAR ADCs and bandgaps
    - Fill info.yaml pinout; rename top module to tt_um_chiranjitpatel_sar_adc
    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
2026-11-01 Add official 1x2 tile size, pin locations and precheck rules to specs
    Taken from TinyTapeout/tt-support-tools (tile_sizes.yaml, tt_analog_1x2.def,
    precheck/tech_data.py, tool-versions.json).
    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
2026-11-01 Add official TT analog specs: pad R/C limits, power stripe rules, no met5
    From tinytapeout.com/specs/analog, /gpio and /clock: ua path < 500 ohm,
    < 5 pF, 4 mA max; met5 forbidden (so only cap_mim_m3_1); vertical met4
    power stripes spanning the tile; tie unused outputs low; pad budget checks.
    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
2026-11-01 Measure VBG and VPTAT through the ADC only
    Drop the analog debug mux: ua[1] now carries only the buffered VREF
    output (ui[1] VREF_OE) or the external VREF input. High-impedance
    bandgap nodes never reach a pad.
    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
2026-11-01 Add bottom-up stage plan for block design and integration
    Stages 0-9 (devices, bias, OTA, bandgap, PTAT, VREF buffer, comparator,
    switch/mux, cap DAC, SAR logic) and integration stages I1-I4, each with
    cells, specs/targets, testbenches, dependencies and a status table.
    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
2026-11-01 Stage 0: device characterization testbenches, gm/Id LUTs and findings
    ngspice testbenches for nfet/pfet (regular and lvt), the bandgap PNP,
    xhigh/high poly resistors and the MIM cap at tt/27 C, plus stage0.py
    post-processing (results.md, lut/*.csv, plots/*.png) and run.sh.
    Key findings: zero-TC VBG is about 1.25 V (above spec B1 max 1.24 V),
    headroom is tight at 1.62 V; PTAT slope 2.01 mV/C; MIM unit cap 9.30 fF.
    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
    [nfet_01v8.csv, nfet_01v8_lvt.csv, pfet_01v8.csv, pfet_01v8_lvt.csv]
2026-11-01 Move spec B1 to 1.25 V (1.21-1.29 V) after stage 0 PNP results
    Update dependent numbers: ADC LSB 4.88 mV, comparator noise limit
    1.22 mV, temperature-sensor resolution 2.4 C/LSB, VREF settling target.
    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
2026-11-01 Stage 1: bias_gen beta-multiplier 1 uA reference, Phase 1 verified
    - xschem/bias_gen.sch/.sym generated by xschem/gen_bias_gen.py
    (nfet_01v8 2/2 with K=4, pfet_01v8_lvt mirror, xhigh_po R1 L=11 um,
    startup and power-down)
    - tools/xsch.py schematic writer and tools/netlist.sh xschem netlister
    - sim/bias testbench + report: 1.004 uA sink / 0.967 uA source,
    2.15 uA own current, 0.7 nA powered down, 6.4% over 1.62-1.98 V,
    starts from 0 V on 1 us and 100 us supply ramps
    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
    [bias_gen.sch]
2026-11-01 Schematic writer: wire stubs to net labels for readable schematics
    Labels no longer overlap the gate/body pins; netlist and stage 1 results
    unchanged.
    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
    [bias_gen.sch]
2026-11-01 Stage 2: two-stage Miller OTA for the bandgap, Phase 1 verified
    - xschem/ota.sch/.sym generated by xschem/gen_ota.py: PMOS-lvt input pair,
    NMOS mirror load, NMOS CS second stage, 0.5 pF MIM Miller cap with
    xhigh_po nulling resistor, power-down
    - sim/ota: open-loop AC, follower range/offset/step and power-down
    testbenches biased from bias_gen, plus report
    - Results (tt/27 C/1.8 V): 80.4 dB, UGF 4.1 MHz, PM 72 deg at 0.5 pF,
    input range <=0.20-1.28 V, 46 uV systematic offset, 5.8 uA, 0.7 nA off
    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
    [ota.sch]
2026-11-01 Add material/ folder with stage 1 and stage 2 transistor-level drawings
    material/schematics holds readable schemdraw drawings of bias_gen and ota
    plus the script that generates them; CLAUDE.md lists the new folder.
    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
2026-11-01 Stage 3: op-amp bandgap core, Phase 1 verified
    - xschem/bandgap_core.sch/.sym from gen_bandgap_core.py: three pfet 8/4
    sources driven by the stage 2 OTA, PNP 1x/8x/1x, R1/R2 = 2/19 xhigh_po
    units, startup from pbias, vgp port for the PTAT branch
    - sim/bandgap: op/temp/line/startup, Middlebrook loop gain + PSRR and
    power-down testbenches, run.sh and report
    - Results (tt/27 C/1.8 V): VBG 1.2154 V, 15.7 uA incl. bias_gen, starts
    0.34 us after a 1 us ramp and on a 100 us ramp, loop 74.9 dB / PM 66 deg,
    22 ppm/C at tt; PSRR at 1 MHz -9.8 dB (fails B7, fix proposed)
    - OTA Miller cap 0.5 -> 0.7 pF for the bandgap loop; stage 2 re-run
    (80.4 dB, PM 81 deg); drawings in material/schematics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
    [bandgap_core.sch, ota.sch]
2026-11-07 Set B1 to 1.215 V (1.18-1.25 V) and add the VREF RC filter to the plan
    Stage 3 showed the real circuit's zero-TC point is 1.2154 V. Dependent
    numbers: ADC LSB 4.75 mV, comparator noise limit 1.19 mV. B7 is now
    specified at the filtered VREF buffer input; stage 5 gains vref_filt.
    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
2026-11-07 Stage 4: PTAT branch for the temperature sensor, Phase 1 verified
    ptat_out mirrors the bandgap core current (pfet 8/4 on vgp) into R3 = 22
    xhigh_po units (R3/R1 = 11). Results at tt: VPTAT 0.599 V, 2.00 mV/C,
    2.37 C/LSB, VBG unchanged by the branch or by loading vptat, bandgap loop
    PM 64 deg with the extra gate.
    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
    [ptat_out.sch]
2026-11-07 Stage 5: VREF RC filter, buffer and reference select, Phase 1 verified
    - vref_filt: ~1.04 MOhm xhigh_po + ~3.9 pF gate cap (pole ~40 kHz)
    - vref_buf: single-stage NMOS-input follower, pfet_lvt mirror, 10 uA,
    ~5.4 pF reservoir cap as dominant pole; power-down via en
    - vref_sel: en_buf/en_pad logic and the ua[1] transmission gate
    - Results (tt/27 C/1.8 V): B7 met at vbg_f (45.8 dB DC, 20.0 dB at 1 MHz),
    1.2 pF DAC-like load recovers to 23 uV per 1 us cycle, stable with pad,
    startup 21 us, external 1.5 V reference and power-down modes verified
    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
    [vref_buf.sch, vref_filt.sch, vref_sel.sch]
2026-11-07 Stage 7: ADC input mux and vcm/top-plate switch, Phase 1 verified
    - inmux: INSEL decoder + four TGs (nfet 4/0.15 + pfet_lvt 8/0.35)
    - vcm_gen: 10 uA diode-connected nfet (vcm ~0.72 V, value cancels),
    ~2 pF decoupling, MTOP top-plate sampling switch
    - Results (tt/27 C/1.8 V): correct selection, crosstalk < 1 uV, VIN
    full-scale step sampled to -10 uV in 1 us through the pad model
    - Decision: VPTAT/VBG (~250 kOhm sources) are converted with clk <= 100 kHz;
    they settle to 0.5 LSB in ~4 us, exact after 10 us
    - DAC switching scheme fixed for stages 8/9 (sim/inmux/README.md)
    Claude-Session: https://claude.ai/code/session_018xb9mH8bN9u9R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
    [inmux.sch, vcm_gen.sch]
2026-11-07 Stage 9: SAR logic in Verilog, verified at RTL and gate level
    - src/sar/sar_logic.v: 10-clock sequencer (sample, 8 bits, EOC) with
    bottom-plate sampling timing (smpt opens at the clk falling edge),
    external mode pass-through
    - test/sar/tb_sar.v: behavioural DAC + comparator model; 2764 conversions
    (code centres, code edges +/-0.01 LSB, random) with 0 errors, RTL and
    gate level (sky130 functional models)
    - Yosys synthesis to sky130_fd_sc_hd: 136 cells, 1217 um^2; filtered
    liberty (tools/filter_liberty.py) excludes lpflow/probe/_0 cells
    - CLAUDE.md: simulator accuracy rules (reltol 1e-5 for precision
    transients, 5 ps steps for comparator decisions, save only needed vectors)
    - insta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
    [sar_logic.v, tb_sar.v]
2026-11-07 Stage 6: StrongARM comparator, Phase 1 verified; simulator and tool fixes
    - comparator: PMOS-lvt-input StrongARM, identical inverters on op/on and a
    NAND SR latch (a NOR latch on op/on gave state-dependent decisions)
    - Results (tt/27 C/1.8 V): 0.44 ns at 1 mV, 22/22 decisions correct,
    correct at CM 0.2/0.6/1.0 V, no net kickback on a floating 2.4 pF node
    - Simulator lessons: reltol 1e-5 instead of a 5 ps step cap (32 s vs
    minutes); num_threads=1 in every .spiceinit (parallel runs with 4
    threads each slowed ~15x); save only needed vectors
    - tools/xsch.py: box-symbol pins always get horizontal stubs (vertical
    stubs on tall symbols overlapped and shorted nets)
    - tools/netlist.sh regen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
    [comparator.sch]
2026-11-07 Rerun stages 3, 4, 5, 7 without the stray PSRR cap; fix netlist.sh
    The stage 3 PSRR-cap sweep left xschem/bandgap_core.sch with a 2.4 pF
    MOS cap (CPS_W=14) after the generator was reset to CPS_W=0, so committed
    schematics and results included it. Regenerated and reran: all checks
    still pass (bandgap PM 82.5 deg, 79.9 deg with PTAT branch; B7 20.9 dB at
    vbg_f). Precision transients now use reltol 1e-5. netlist.sh also enables
    '*+' continuation lines of long .subckt port lists.
    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
    [bandgap_core.sch]
2026-11-07 Stage 8: 8-bit MIM cap DAC, Phase 1 verified; top-level digital block
    - dac_sw (TG to vadc, pfet_lvt 4/0.35 to vref, nfet to VGND, NOR/NAND
    drive) and cap_dac (128..1 + termination, 256 x 2x2 um MIM, 2.38 pF)
    - All 256 codes at tt: gain 1.00000, DNL 0.001 / INL 0.0007 LSB, 0.6 pA
    top-plate leak (the default-tolerance run's 0.1 LSB DNL was numerical)
    - src/sar/adc_digital.v: TT pin decoding around sar_logic (MODE gating of
    START/VREF_OE/BG_PD, uio_oe, tie-offs); RTL + gate-level tests pass;
    153 cells, 1289 um^2
    - tools/gl2spice.py: Yosys gate netlist -> SPICE with sky130 std cells,
    now expanding bus/concatenation/constant assigns
    - Tolerances: abstol 1e-12 / vntol 1e-7 (1e-14 aborte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
    [cap_dac.sch, dac_sw.sch]
2026-11-07 Draft datasheet and test procedure in docs/info.md
    How it works, pin table for internal/external mode, and an 8-step test
    procedure from the TT demo board (basic conversion, VREF readout, linearity,
    temperature sensor with clk <= 100 kHz, VBG via external reference,
    fallbacks, offset check). Marked as draft until corners and layout.
    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
2026-11-07 Add I2 adc_core and I4 top-level schematics
    - adc_core: cap_dac + comparator + vcm_gen + std-cell sar_logic (I2)
    - tt_um_chiranjitpatel_sar_adc: all proven blocks + adc_digital with the
    TT template ports; bias_gen always on (vcm needs it), bandgap pd = BG_PD,
    VREF buffer enabled via vref_sel; ua[2..7] left for VGND ties in layout
    - symbols for the synthesized digital blocks (sar_logic, adc_digital)
    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
    [adc_core.sch, tt_um_chiranjitpatel_sar_adc.sch]
2026-11-07 Add Phase 2 corner/temperature/supply/Monte Carlo runner and I2/I3 testbench generator
    tools/run_corners.py rewrites an existing testbench per corner x temp x VDD
    (or N Monte Carlo seeds on a *_mm section), runs them in parallel with one
    thread each and collects all printed/measured values into a CSV. Checked on
    tb_bias: tt reproduces the stage 1 result exactly.
    sim/adc/make_tb.py builds adc_core testbenches (ideal VREF for I2,
    --real-ref for I3); decode.py reads the codes at each EOC.
    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
2026-11-07 Add generated I2/I3 quick testbenches (5 conversions each)
    Produced by sim/adc/make_tb.py: tb_quick (ideal VREF) and tb_quick_ref
    (real bandgap -> filter -> buffer reference).
    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
2026-11-07 Fix smpt glitch in sar_logic found in I2; fix stepped VIN in ADC testbench
    - smpt was combinational (tracking & ~(SAMPLE & ~clk)) and glitched high on
    the clock edge that ends SAMPLE, re-sampling the top plate while the
    bottom plates switched (wrong codes in the first transistor-level run).
    It is now a falling-edge flip-flop. tb_sar checks one smpt falling edge
    per conversion: the old gate netlist fails in every conversion, the new
    one passes (RTL + gate level: 2764 conversions, 0 errors). 120 cells.
    - make_tb.py: VIN PWL now holds each value (one point per value ramped)
    Claude-Session: https://claude.ai/code/session_018xb9mH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
    [sar_logic.v, tb_sar.v]
2026-11-07 Comparator: add continuous-time preamp against kickback (verification running)
    The first transistor-level ADC run (I2) showed a constant -2 LSB offset:
    at the comparator clock edge the tail turn-on kicks vtop (+5 mV, DAC caps
    behind ~kOhm switches) more than vcm (+3 mV, direct decoupling), and the
    latch decides inside that ~9 mV differential transient. A PMOS-lvt preamp
    (4 uA tail from pbias, diode NMOS loads, gain ~2) now sits between the
    inputs and the StrongARM, so the latch kick lands symmetrically on the
    preamp outputs. Comparator gets a pbias port; adc_core/top/testbenches
    updated. netlist.sh runs generators leaf-first. Results follow in the
    next commit.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
    [adc_core.sch, comparator.sch, tt_um_chiranjitpatel_sar_adc.sch]
2026-11-07 Stage 6 rerun with preamp: kickback peak 3.4 mV -> 0.02 mV
    All 1 mV decisions correct at CM 0.2/0.6/1.0 V, 0.59 ns at 1 mV,
    toggle point within +/-0.5 mV, 3.9 uA. README and drawing explain why the
    preamp was added (kickback asymmetry found in I2).
    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
2026-11-07 I2 full ADC: 5/5 conversions exact at transistor level; long runs started
    After the smpt and kickback fixes, the transistor-level ADC (std-cell SAR,
    DAC, preamp comparator, vcm_gen; ideal VREF) converts 0.1/0.3/0.6/0.9/1.15 V
    to exactly the ideal codes. I3 (real reference), a code-edge test and a
    64-point sine are running. I1 merged into I2.
    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
2026-11-07 Split long ADC runs into <2 h pieces (detached runs were killed between turns)
    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
2026-11-07 I2 code edges 18/18 and I3 self-referenced ADC 5/5 at transistor level
    All major carry transitions resolve within 0.2 LSB of ideal (ideal VREF);
    with the real bandgap -> RC filter -> buffer reference (1.2143 V) the five
    test inputs give exactly the ideal codes. 64-point sine split in 4 chunks.
    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
2026-11-08 M0: top-level frame from tt_analog_1x2.def, outputs tied to VGND
    layout/m0_frame.py drives Magic (TT magic_init_project.tcl recipe): DEF
    outline and pins, VDPWR/VGND met4 stripes (2 um, y 5..220.76 um), all 24
    digital outputs tied to VGND (met4 stub -> via3 -> met3 bar -> VGND).
    Magic DRC 0 errors; extraction shows exactly the 24 output-to-VGND ties;
    LEF has all 53 pins, 161.000 x 225.760 um. Adds the layout milestone/chunk
    plan (docs/specs/layout_plan.md, deadline 2026-12-01).
    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
2026-11-08 Add GDS render script and M0 frame picture
    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
2026-11-08 Floorplan draft (chunk 0b); M0 frame with all six power stripes
    - layout/floorplan.py -> floorplan.json + material/layout/floorplan.png:
    every block placed (sized from netlist device areas), checks for tile
    bounds, overlaps and stripe clearance; 55 % used, 3900 um^2 reserve.
    docs/specs/floorplan.md explains placement, power, routing layers.
    - Power: three VDPWR/VGND met4 pairs (x = 1/4, 64/67, 154.5/157.5), none
    crossing the MIM array or the digital macro; stripes end at y = 217
    (TT: reach the top 10 um) so they clear the output-pin tie stubs.
    - M0 regenerated from the floorplan: Magic DRC 0, exactly 24 output-to-
    VGND ties and no other shorts in extraction, 53 LEF pins.
    - CLAUDE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
2026-11-08 M0: fix precheck failures (cell name was the full path; ua[0]/ua[1] unconnected)
    Magic named the cell after the absolute save path, so the GDS/LEF top cell was
    '/home/.../tt_um_...': top macro name, pin, cell name and urpm checks failed.
    Save by name from inside mag/. Add a met4 stub on each used analog pin
    (analog_pins = 2). TT's own klayout_checks, cell_name, analog_pin, boundary,
    pin_check and power_pin checks pass locally.
    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
2026-11-08 Chunk 1a in progress: MS2 as 5 series devices, block LVS checker, bias_gen layout brief draft
    - bias_gen: the 0.42/50 startup pull-up becomes 5 x 0.42/10 in series (fits
    the 22 x 26 um outline); stage 1 re-run, all targets met.
    - tb_bias uses method=gear (trapezoidal left a 10 % error current after
    the fast startup ramp with all node voltages already settled).
    - run_corners.py also rewrites '.param vdd' and VDD pulse ramps.
    - layout/check_cell.py: Magic DRC + extraction from GDS + netgen LVS
    (property errors count as a fail), optional RC extraction.
    - docs/specs/layout_briefs/bias_gen.md: draft brief (corner sweep running).
    Claud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
    [bias_gen.sch]
2026-11-08 bias_gen: layout dummies in the schematic; nodesets for a robust .op
    - MDN1/2 (nfet 2/2) and MDP1/2 (pfet_lvt 2/2), all terminals on the rail:
    netgen does not drop shorted devices, so they must be in the schematic.
    - First corner sweep: at tt/27 C/1.98 V the plain .op converged to a
    non-physical point (v(nr) = 2e6 V, 0.32 uA) while the DC sweep and both
    startup transients give 1.036 uA. Nodesets near the running state; the
    corner report now cross-checks every .op current against the DC sweep.
    Sweep re-running.
    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
    [bias_gen.sch]
2026-11-08 Chunk 1a: bias_gen Phase 2 done (45/45), layout brief final
    5 corners x -40/27/125 C x 1.62/1.80/1.98 V: unit sink 0.68-1.64 uA
    (mostly temperature, I ~ VT/R1), line <= 8.9 %, startup 45/45 on both
    ramps (running by VDPWR <= 0.98 V), power-down <= 43 nA.
    - Power-down switches L 0.15 -> 0.5, pd inverter L 0.15 -> 1: the
    minimum-length inverter PMOS leaked 1.5 uA at 125 C in power-down.
    - Testbench drives pd from VDPWR (a fixed 1.8 V 'high' left PMOS
    switches partly on at 1.98 V).
    - Brief docs/specs/layout_briefs/bias_gen.md has the final sizes.
    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
    [bias_gen.sch]
2026-11-08 Chunk 1c: scripted PNP array and R1/R2 resistor array, DRC + LVS clean
    - layout/magic_lib.py: helpers for Magic-scripted layout (PDK gencells,
    paint, via stacks, pins, batch run -> layout/cells/<cell>.gds).
    - pnp_array: Q1 centre + 8 x Q2 common centroid, Q3 and 2 dummies in a
    4th column (pnp_05v5_W3p40L3p40, 6.44 um pitch, 26 x 19 um). Emitters
    on separate layers (vq2 met2 ring, va / vq3 met3). Magic DRC 0, LVS
    match; pin order checked in the extracted netlist (C B E).
    - bg_res: 23 x xhigh_po 0.35/2 in one guard ring: R1 at positions 5/15
    (same centroid as R2), R2 serpentine of 19, dummies on VGND. The
    generator's l=2.16 extracts as L=2 (= schematic). DRC 0, LVS match;
    chain l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
2026-11-08 Chunks 1e/1f scripted (ptat_out, vref_filt); fix two holes in the Magic DRC count
    Magic DRC count fixes (check_cell.py, magic_lib.py, m0_frame.py):
    - 'drc list count total' reported 0 while 'drc listall why' listed errors;
    the count now comes from the full list (drc(full) style).
    - An error region can lie outside the cell's bounding box (a too-thin
    wire is marked up to the required width), and 'drc listall' only
    returns errors inside the box: the box is grown by 5 um first.
    A deliberate 0.10 um met1 wire was reported as 0 errors before, 1 now.
    All cells and M0 re-checked: 0.
    - layout/klayout_drc.py: TT precheck deck (feol/beol/offgrid) in the
    LibreLane container; catches the same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
    [ptat_out.sch, vref_filt.sch]
2026-11-08 Bandgap Phase 2 (mismatch): sigma(VBG) 54 -> 17.6 mV; loop, startup and B7 re-fixed
    Monte Carlo (tt_mm, 100 seeds) found sigma(VBG) = 54 mV, driven by the OTA
    offset times 1 + R2/R1. Sizing experiments (40 seeds each, sim/bandgap/mc_stats.py)
    split it into OTA ~49, R2/R1 ratio 15, PMOS sources 8, PNPs 5 mV. Changes:
    - OTA: input pair pfet_lvt 8/2 -> 32/8, loads 1/4 -> 4/16 (M6 4 x 4/16);
    CC 0.7 -> 2.1 pF (32 x 32 MIM), RZ 40 -> 120 kOhm: loop PM 9.5 -> 76.4 deg.
    - R1/R2/R3 units res_xhigh_po 0.35/2 -> 0.69/4 (4x area, same R).
    - Current sources MPA/B/C and ptat MPP pfet 8/4 -> 16/8.
    - Startup MSU1 L 1 -> 4: the strong kick caused a startup limit cycle with
    the slower loop (VBG swinging 0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
    [bandgap_core.sch, ota.sch, ptat_out.sch, vref_filt.sch]
2026-11-08 Bandgap Phase 2 corners: 63/63 pass (spread -0.4/+0.3 %, TC <= 33 ppm/C, line <= 9.9 mV/V)
    - corners_report.py: 7 corners (incl. resistor ll/hh) x 3 temperatures x 3
    supplies; per-run -40..125 C sweep for the TC; startup checked for settling
    and sustained oscillation on both ramps.
    - bandgap.md Status updated; B6 note: corners pass, mismatch sigma 17.6 mV
    (3 sigma ~ +-4.4 %) -> open decision for the designer (recommended: reword
    B6 and calibrate through the VREF readout on ua[1]).
    - Layout dummies in the bandgap_core (2 PNP, 2 resistor) and ota (2 pfet_lvt
    16/8, 2 nfet 4/16) schematics; Phase 1 unchanged.
    - OTA stage-2 results re-run; the unity-gain follower test is no longer a use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
    [bandgap_core.sch, ota.sch]
2026-11-08 Temperature sensor Phase 2: corners <= 2.6 C (1-point); mismatch needs 2-point calibration
    - tb_ptat_p2(_mc).spice + sensor_report.py: VPTAT/VBG over -40..125 C (what the
    ADC measures), error after calibration, for 21 corner runs and 100 MC seeds.
    - Corners: VPTAT 0.600 V, slope 1.95-1.97 mV/C, worst error 2.6 C (1 point).
    - Mismatch: slope sigma 1.6 %; 1-point calibration leaves 10 % of seeds above
    +-5 C (B13), a 2-point calibration keeps all within 2.7 C. B13 note added
    (open decision); info.md test procedure gives both calibrations, the VREF
    calibration via ua[1] and the 100 us power-up wait.
    Claude-Session: https://claude.a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
2026-11-08 VREF chain Phase 2 corners (45 runs): all pass except B7 DC at 1.62 V (open)
    - corners_report.py for the VREF chain; corners.md: 1 MHz PSRR >= 20.3 dB,
    DAC-load error <= 108 uV, startup <= 52 us, buffer offset <= 7.1 mV.
    - B7 DC: 30.4-36.6 dB in 7 runs, all at 1.62 V and -40/125 C. Diagnosed as
    headroom (OTA pair/tail edge of triode, MPC at 0.42 V); two cheap resizes
    did not fix it. 0.07 LSB effect; B7 note with a recommendation in bandgap.md.
    - stage_plan and layout_plan status for stages 3-5 and chunks 1a-1f.
    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
2026-11-12 Reword B6 (process +-3 % / mismatch sigma <= 20 mV), B7 (DC 30 dB at 1.62 V), B13 (2-point calibration); Claude takes over the M1 layout chunks
    Decided with the designer 2026-11-12: keep the circuit, calibrate VREF and the
    temperature sensor in firmware (test procedure in docs/info.md).
    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
2026-11-12 Chunk 1a: bias_gen scripted layout (53.6 x 23.9 um), DRC 0 (Magic + KLayout), LVS match
    - layout/mos_cell.py: rows of PDK devices with separate guard rings joined by a
    met1 rail bar, li straps for rail terminals, direct series jumpers, and a
    met2-stub / met3-track channel with vertical-constraint ordering.
    - Found on the way: Magic silently drops a via2 drawn 0.26 um (no cut, no DRC
    error): every channel connection was open until via2 >= 0.32 um.
    - Schematic changes to fit 54 x 26 um: startup MS2 2 x 0.42/10 (was 5),
    MS3 W 4; R1 = 2 x 0.35/5.45 in series (+2 dummies); PD switches L = 1 (also
    in the OTA/bandgap). Phase 1 + 45 corners re-verified; bandgap unchanged.
    - layout/drc_wher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
    [bandgap_core.sch, bias_gen.sch, ota.sch]
2026-11-12 Chunk 1b: OTA scripted layout (68.7 x 47.8 um), DRC 0 (Magic + KLayout), LVS match
    - layout/mos_rows.py: any number of device rows with channels between them,
    rotated devices (long L vertical), side buses for multi-channel nets and
    pins, rail buses, ring met1 only on the rail-bar side, rotation/flip in
    the Magic helpers.
    - OTA: loads M6 M3 M4 M6 (4/16 rotated; M6 as 2 x 8/16) + RZ + PD switches;
    input pair D A B B A D (16/8 halves, dummies 16/1) + M5/M7; CC as 4 x MIM
    16 x 16 over the rows (mirrored pairs: top plates meet in the middle).
    - Schematic: CC 4 x 16x16, RZ 2 x 10.45 um in series (+2 dummies), pair
    dummies 2 x 16/1, no load dummies. Bandgap re-verified: VBG 1.2105 V,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
    [ota.sch]
2026-11-12 Chunk 1d: bandgap_core assembled (71.7 x 104 um), DRC 0 (Magic + KLayout), LVS match
    One row cell (OTA rows + current sources D MPA MPB MPC D + startup, MIM
    Miller cap over the OTA rows) with pnp_array and bg_res placed in a band
    under it (Magic getcell); band nets routed on met2 drops / met3 tracks to
    the side buses. 30 devices / 16 nets match the schematic (OTA flattened).
    Source dummies (2 x pfet 16/1) added to the schematic; bandgap unchanged
    (VBG 1.2105 V, PM 77.1 deg). Needs a ~72 um wide left column (floorplan
    revision with the M1 integration).
    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
    [bandgap_core.sch]
2026-11-12 Chunks 1g/1h: vref_buf (43 x 57 um) and vref_sel (30 x 30 um) scripted, DRC 0 (Magic + KLayout), LVS match
    - Short-L devices (MSW 4/0.15, TG 10/0.15 and 20/0.35): drawn rotated, so
    D/S are horizontal strips with their vias W/4 off centre in opposite
    directions (the strips of a 0.15 um device are only 0.44 um apart);
    gate pad pushed toward the li-only ring line; the unused gate contact
    gets a met1 pad (min area).
    - met2 landings at the via1 enclosure minimum.
    - vref_sel logic L 0.15 -> 1 and vref_buf MPU L -> 1 (static logic);
    stage 5 re-run: VREF 1.2095 V, DAC-load error 7 uV, all 4 selector modes OK.
    - OTA and bandgap_core regenerated with the framework changes: still DRC 0 /
    LV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
    [vref_buf.sch, vref_sel.sch]
